ericrobles320140/Chilly-Dog-Team-31-ECEN_404/403/403/Con Ops/Block Diagram.docx

power cord power cord cool/warm air

Car Window

Solar Panels

hose air intake

12 V Outlet

power cord power

HVAC system

Battery

power

Microcontroller

temperature control

temperature sensor

wifi temperature settings

Phone Application
