ericrobles320140/Chilly-Dog-Team-31-ECEN_404/403/403/Con Ops/Figures 3.1 and 3.2.pptx

Clip

Exhaust Hose

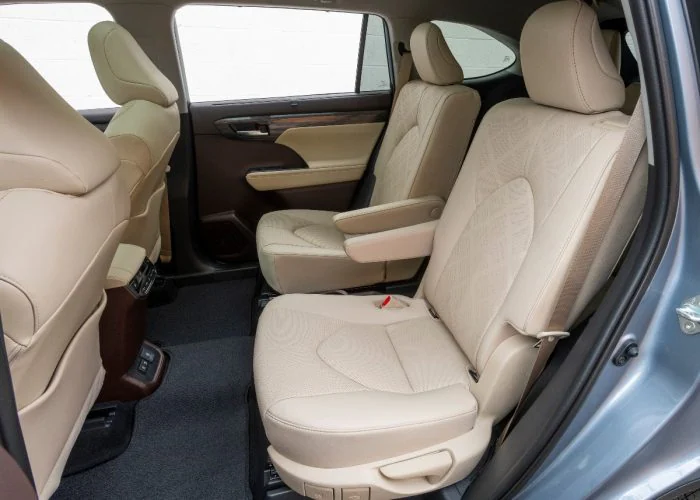
[picture p31: figure]

Power Button

Air Output

## Slide 2

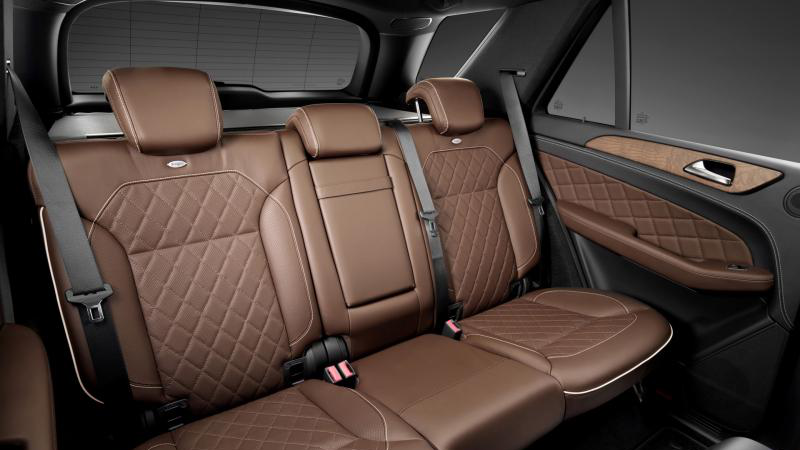
[picture p32: figure]

Exhaust Hose

Air Output

Car Plug

## Slide 3

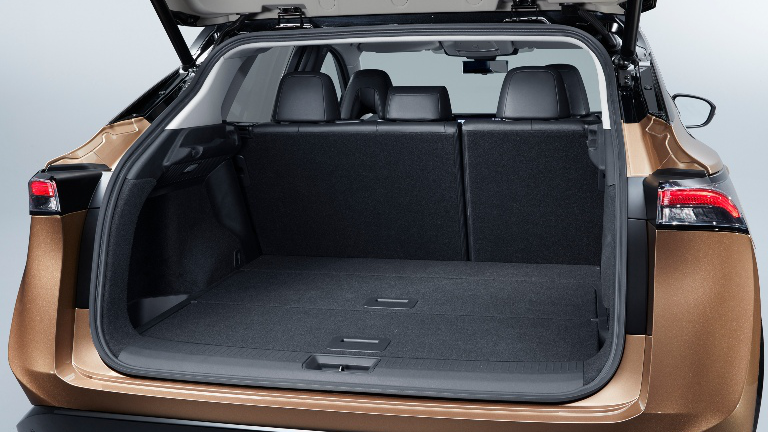
[picture p33: figure]

Air Output

Car Plug

## Slide 4

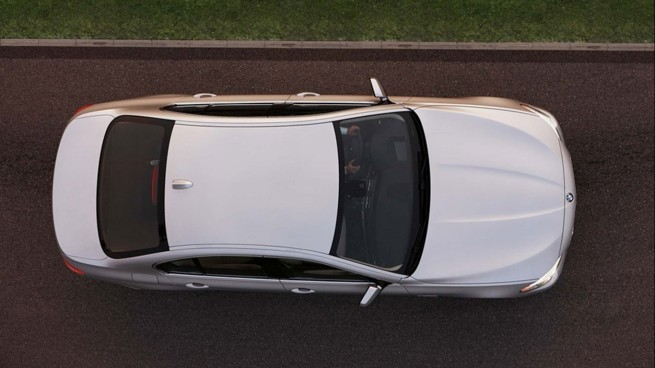
[picture p34: figure]
Results Now In: Guess These 10 Cars From A Bird&#39;s Eye View: Part 2

Solar Panels
