ericrobles320140/Chilly-Dog-Team-31-ECEN_404/Power/Power Supply/Power Supply Simulation/Power Supply Circuit Simulations.docx

MCU WEBENCH

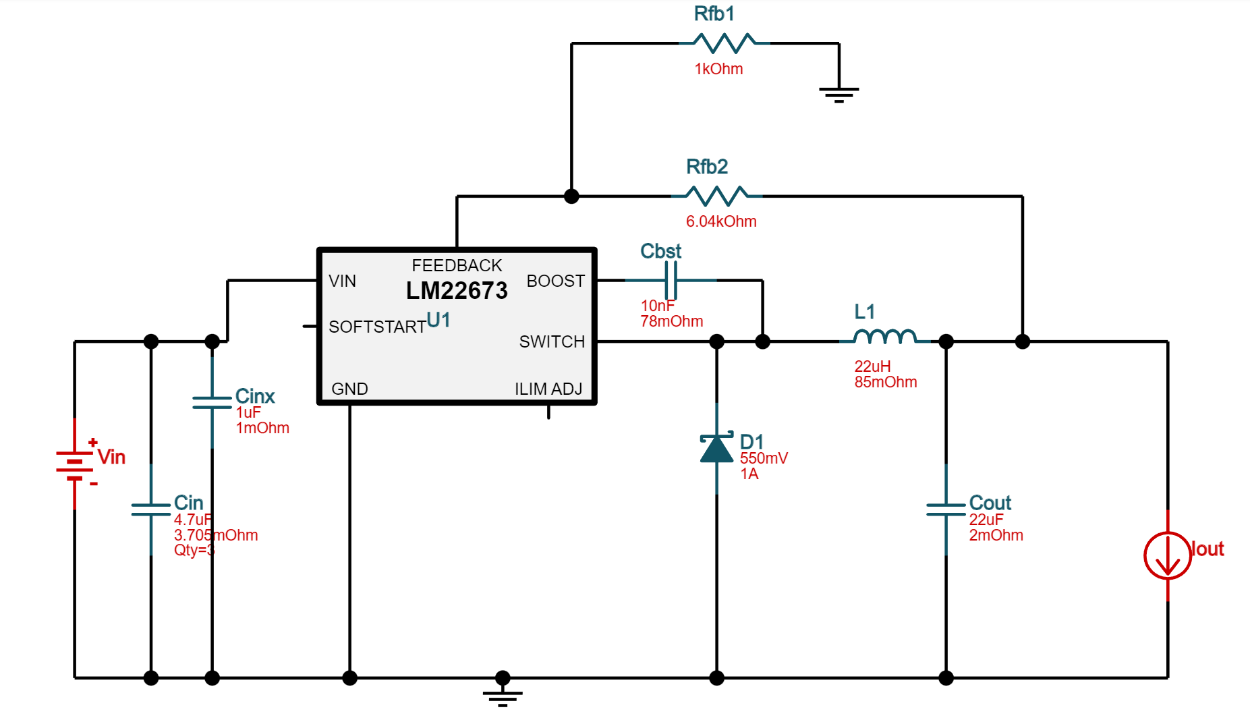
[picture p146: figure]

- Load Regulation

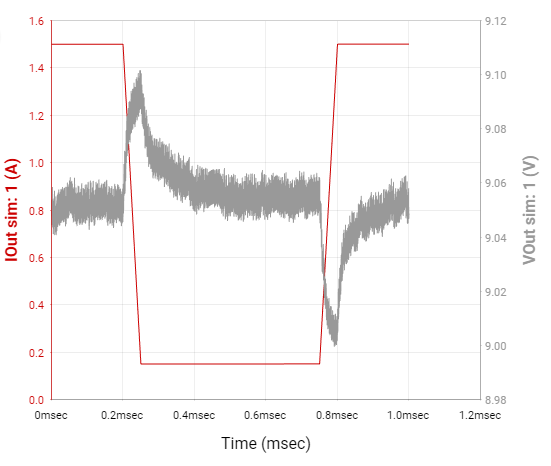
[picture p147: figure]

- Line Regulation

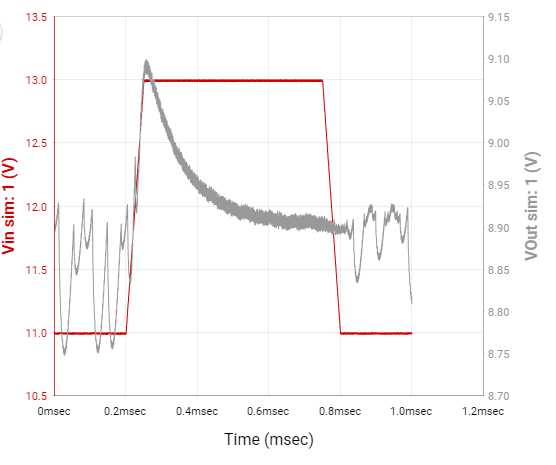
[picture p148: figure]

MODEM WEBENCH

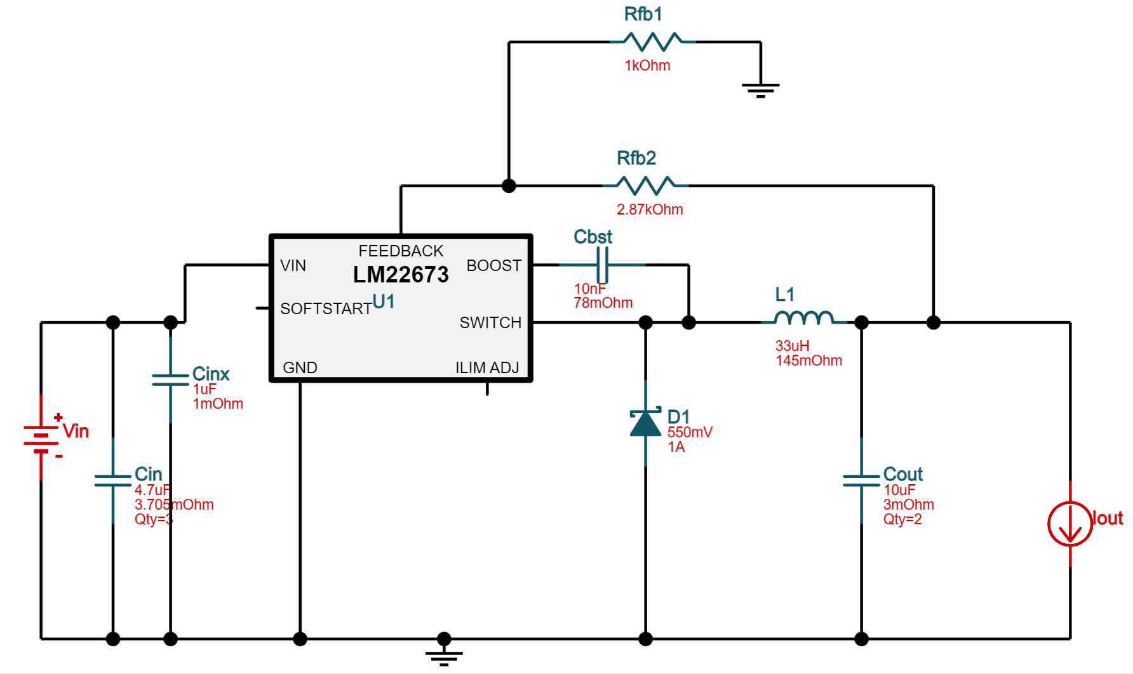
[picture p149: figure]

- Load Regulation

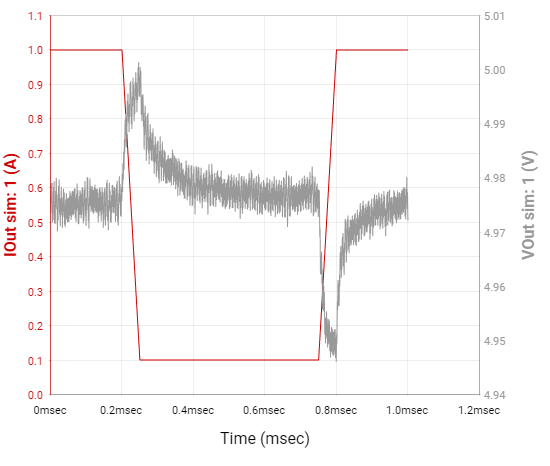
[picture p150: figure]

- Line Regulation

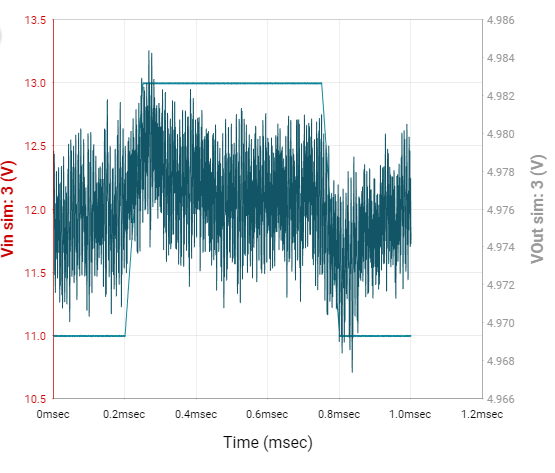
[picture p151: figure]
