ericrobles320140/Chilly-Dog-Team-31-ECEN_404/403/403/General Resources/Capstone Block Diagram.png

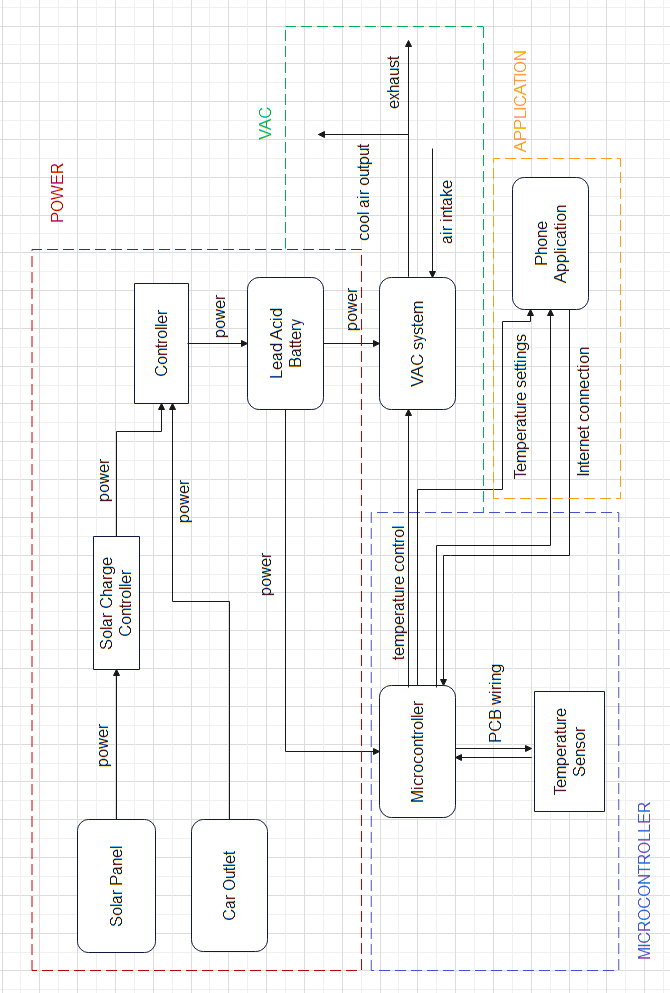
403/403/General Resources/Capstone Block Diagram.png
