ericrobles320140/Chilly-Dog-Team-31-ECEN_404/App and Modem/adding-different-dev.png

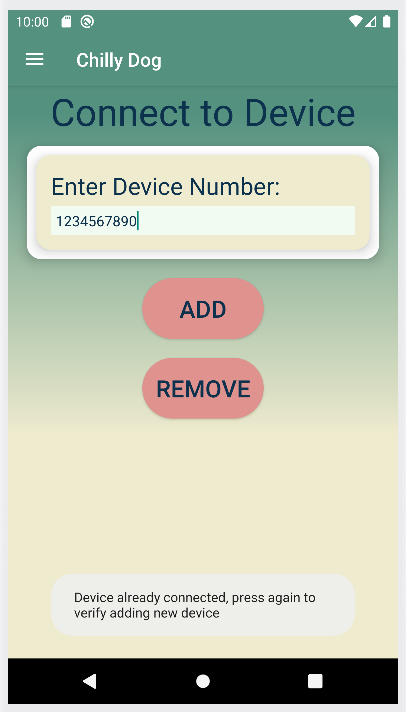
App and Modem/adding-different-dev.png
