ericrobles320140/Chilly-Dog-Team-31-ECEN_404/App and Modem/App-Home.png

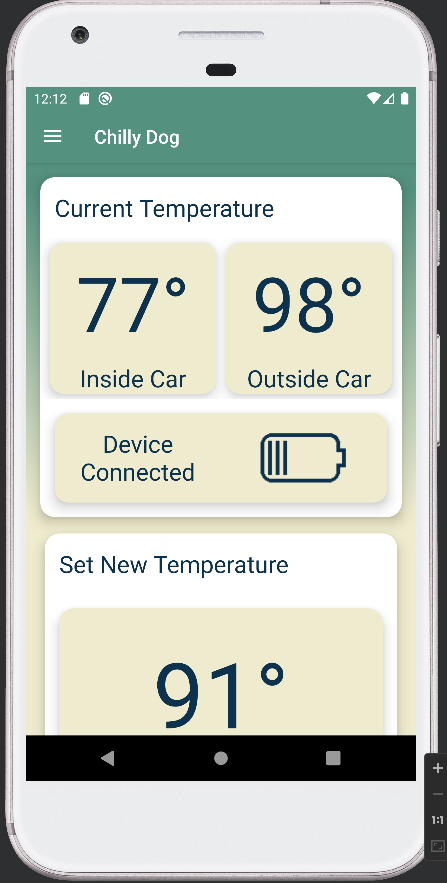
App and Modem/App-Home.png
