ericrobles320140/Chilly-Dog-Team-31-ECEN_404/App and Modem/app_warning_codes.png

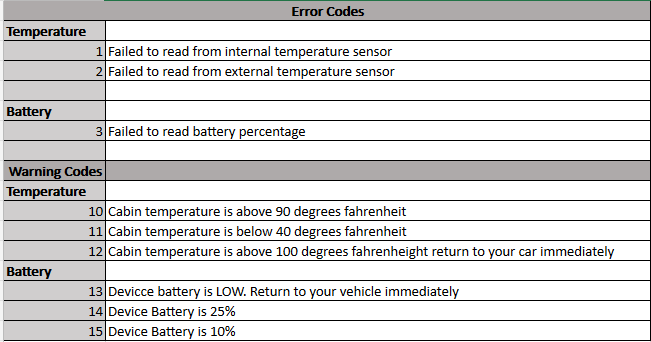
App and Modem/app_warning_codes.png
