ericrobles320140/Chilly-Dog-Team-31-ECEN_404/App and Modem/AppConDev.png

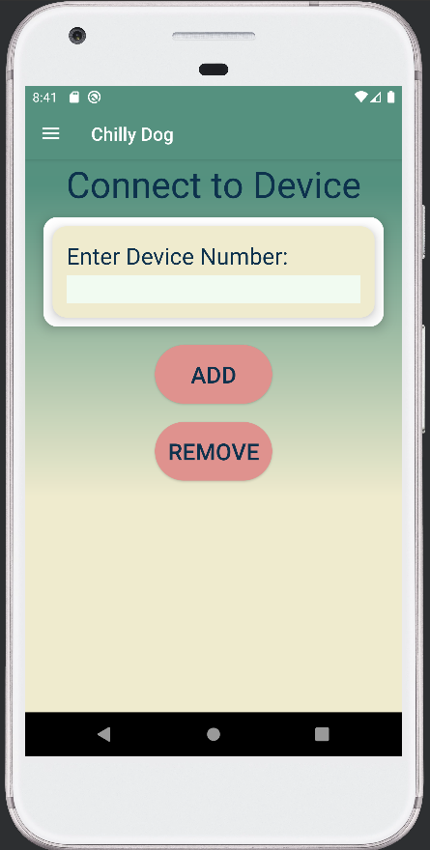
App and Modem/AppConDev.png
