ericrobles320140/Chilly-Dog-Team-31-ECEN_404/App and Modem/AppHome.png

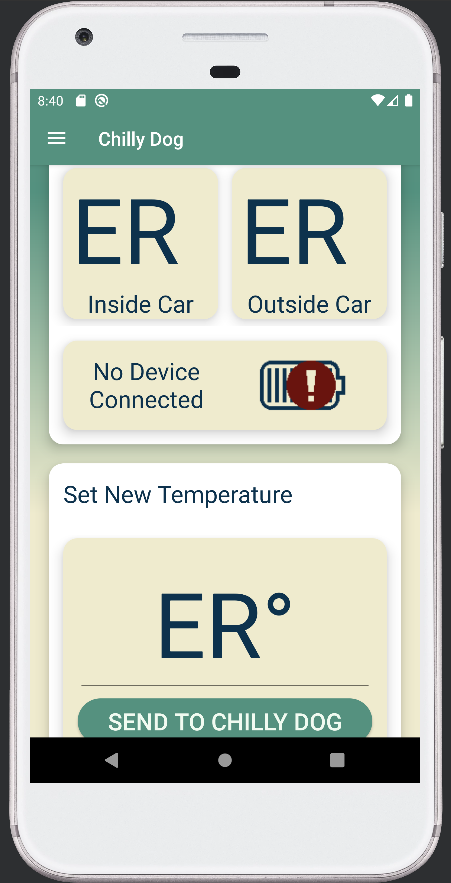
App and Modem/AppHome.png
