ericrobles320140/Chilly-Dog-Team-31-ECEN_404/App and Modem/AppNotif.png

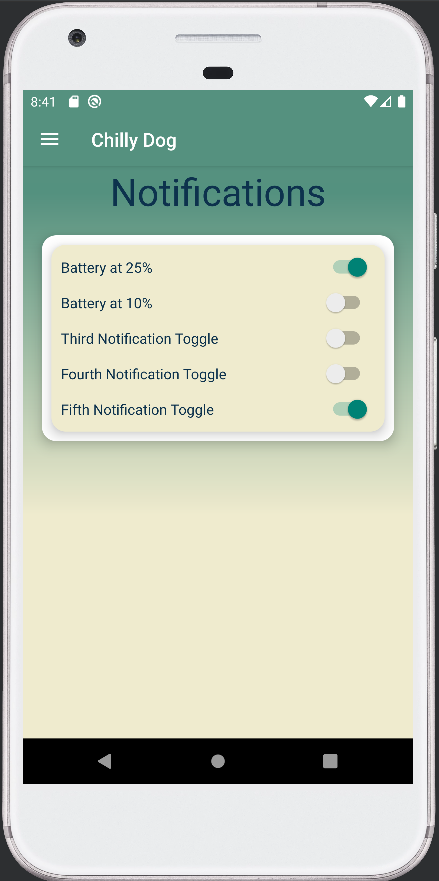
App and Modem/AppNotif.png
