ericrobles320140/Chilly-Dog-Team-31-ECEN_404/App and Modem/AppShowUpdate.png

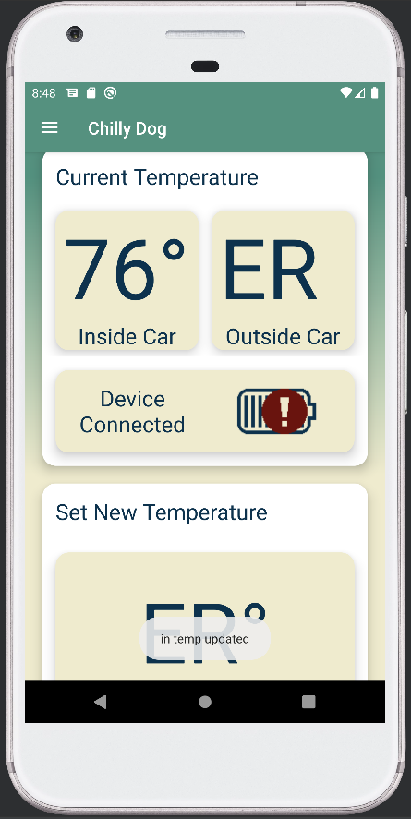
App and Modem/AppShowUpdate.png
