ericrobles320140/Chilly-Dog-Team-31-ECEN_404/App and Modem/bluetooth_permissions.png

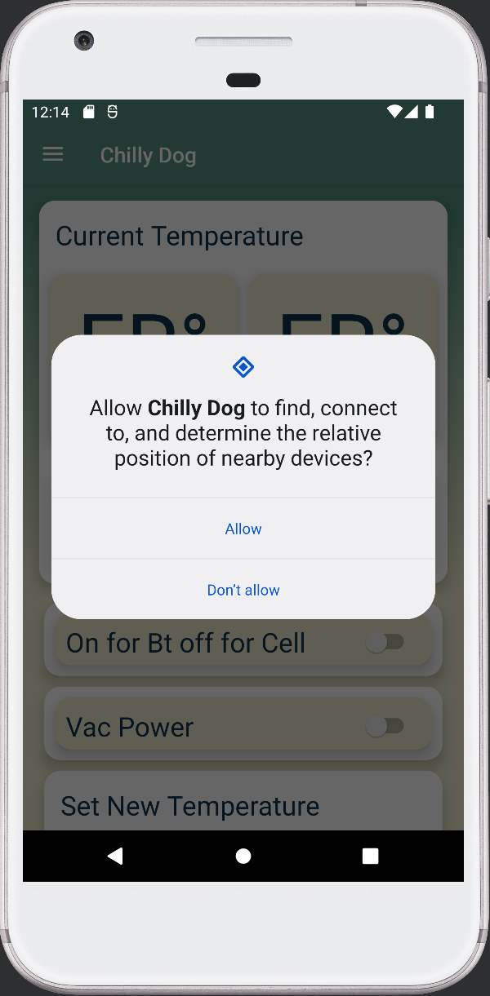
App and Modem/bluetooth_permissions.png
