ericrobles320140/Chilly-Dog-Team-31-ECEN_404/App and Modem/cleared-device.png

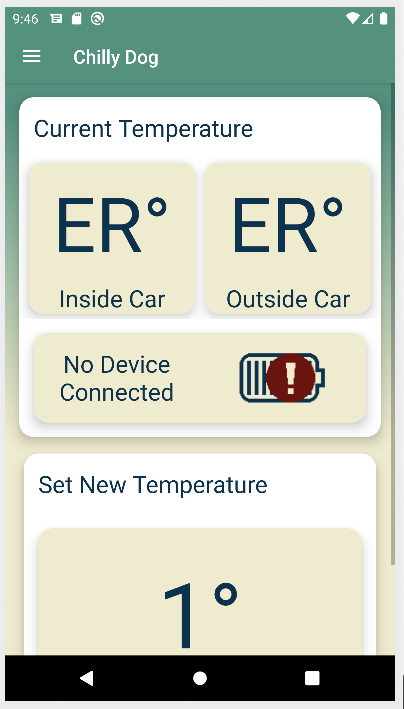
App and Modem/cleared-device.png
