ericrobles320140/Chilly-Dog-Team-31-ECEN_404/App and Modem/connect_device_screen.png

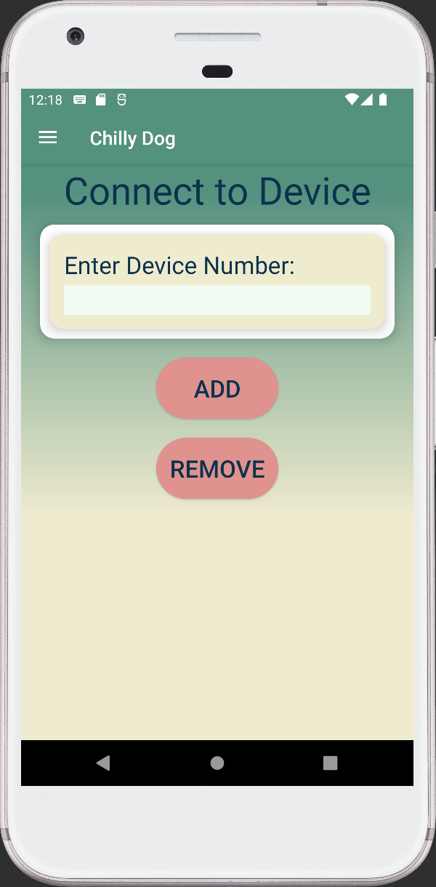
App and Modem/connect_device_screen.png
