ericrobles320140/Chilly-Dog-Team-31-ECEN_404/App and Modem/correct-send.png

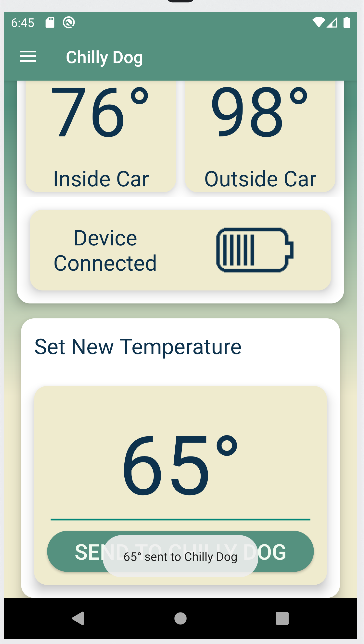
App and Modem/correct-send.png
