ericrobles320140/Chilly-Dog-Team-31-ECEN_404/App and Modem/decimal-adddev.png

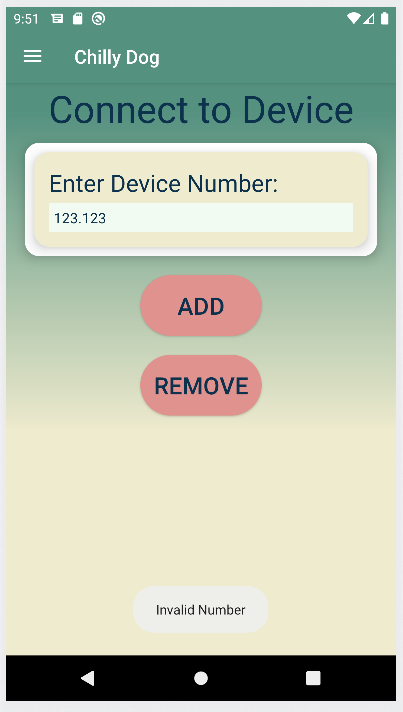
App and Modem/decimal-adddev.png
