ericrobles320140/Chilly-Dog-Team-31-ECEN_404/App and Modem/err1.png

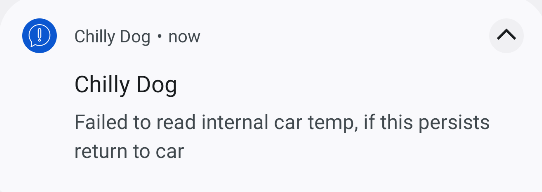
App and Modem/err1.png
