ericrobles320140/Chilly-Dog-Team-31-ECEN_404/App and Modem/err13.png

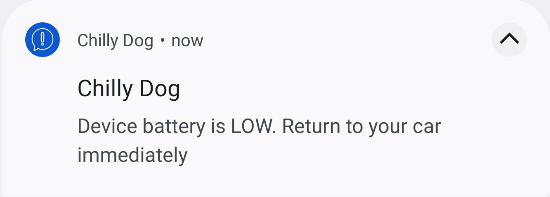
App and Modem/err13.png
