ericrobles320140/Chilly-Dog-Team-31-ECEN_404/App and Modem/homescreen_filled.png

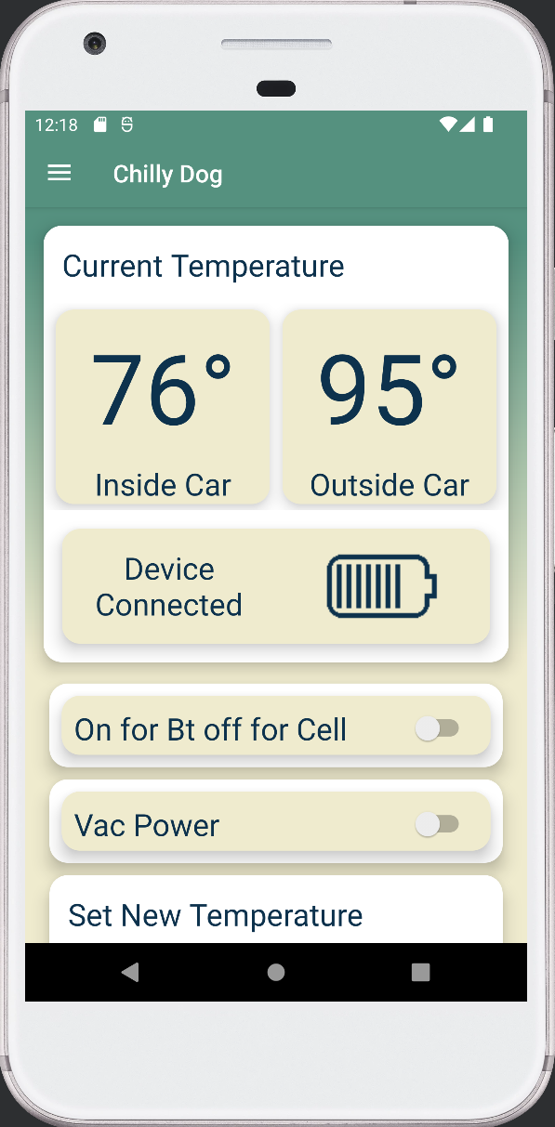
App and Modem/homescreen_filled.png
