ericrobles320140/Chilly-Dog-Team-31-ECEN_404/App and Modem/homescreen_no_fill.png

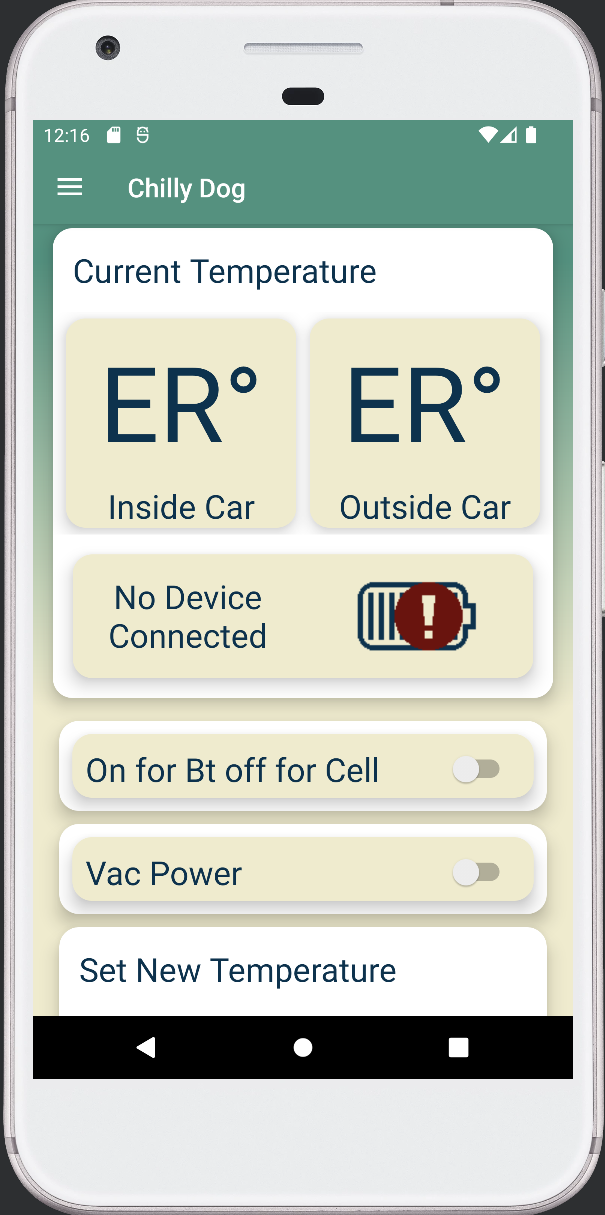
App and Modem/homescreen_no_fill.png
