ericrobles320140/Chilly-Dog-Team-31-ECEN_404/App and Modem/incorrect-nodigit2-adddev.png

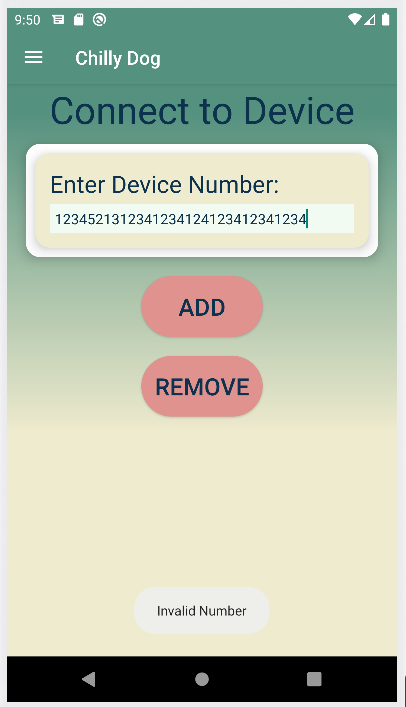
App and Modem/incorrect-nodigit2-adddev.png
