ericrobles320140/Chilly-Dog-Team-31-ECEN_404/App and Modem/modem_out_3.png

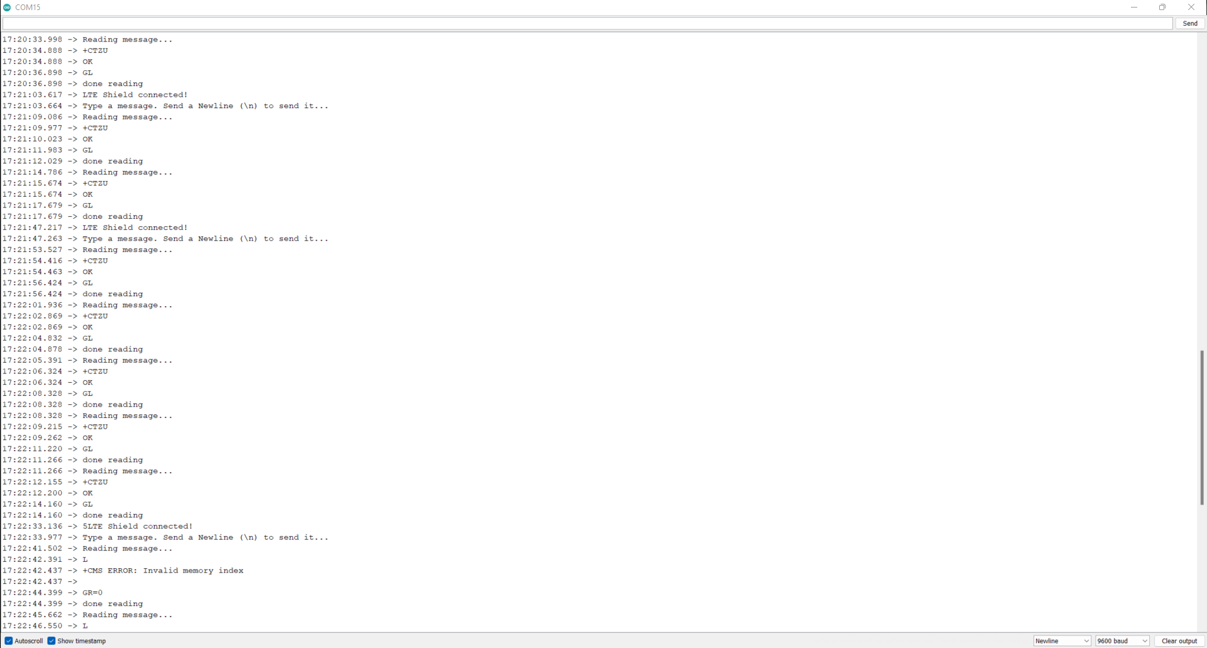
App and Modem/modem_out_3.png
