ericrobles320140/Chilly-Dog-Team-31-ECEN_404/App and Modem/nan check.png

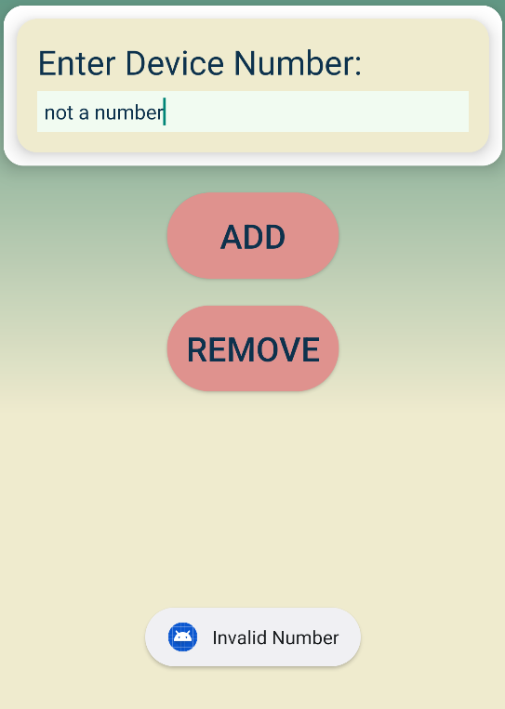
App and Modem/nan check.png
