ericrobles320140/Chilly-Dog-Team-31-ECEN_404/App and Modem/notif-on-and-rec.png

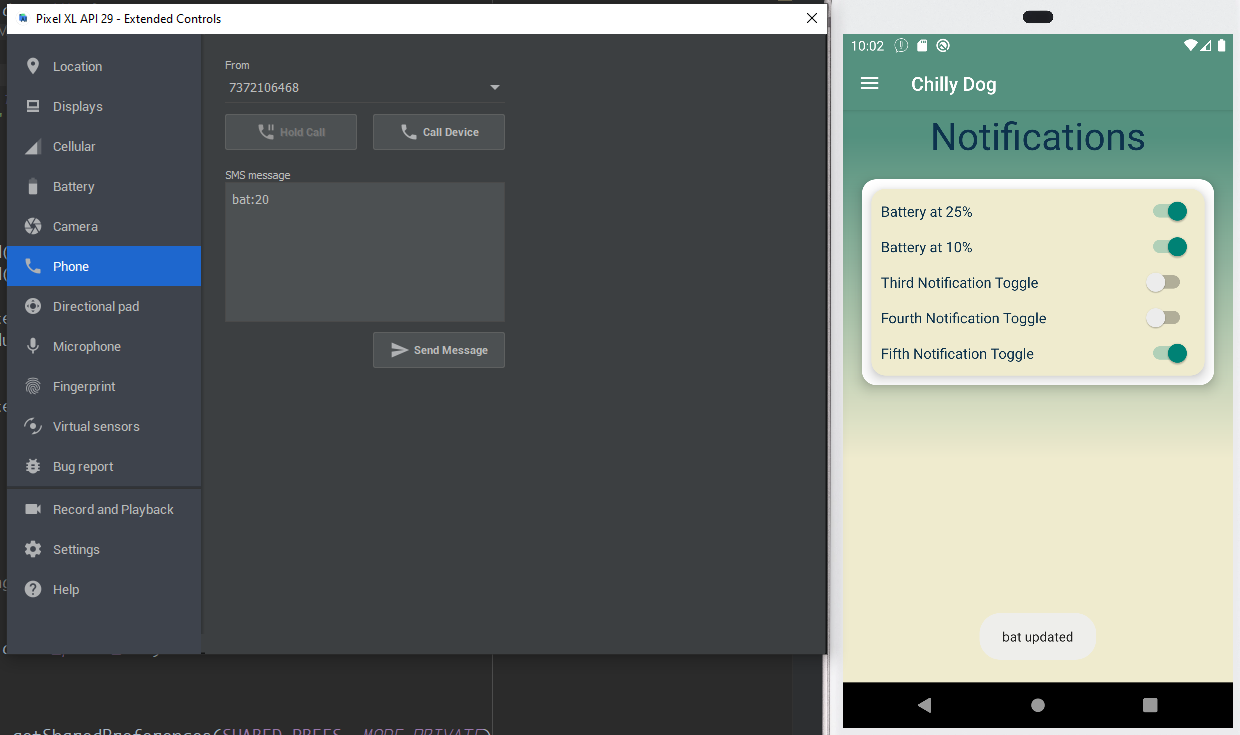
App and Modem/notif-on-and-rec.png
