ericrobles320140/Chilly-Dog-Team-31-ECEN_404/App and Modem/notification-off.png

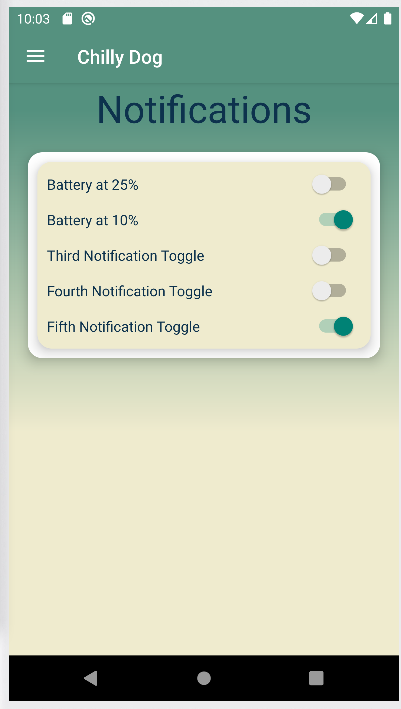
App and Modem/notification-off.png
