ericrobles320140/Chilly-Dog-Team-31-ECEN_404/App and Modem/notification-on.png

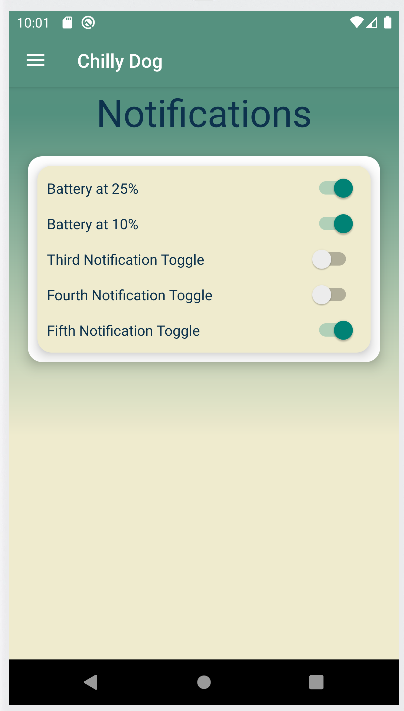
App and Modem/notification-on.png
