ericrobles320140/Chilly-Dog-Team-31-ECEN_404/App and Modem/out-of-range-sent-again.png

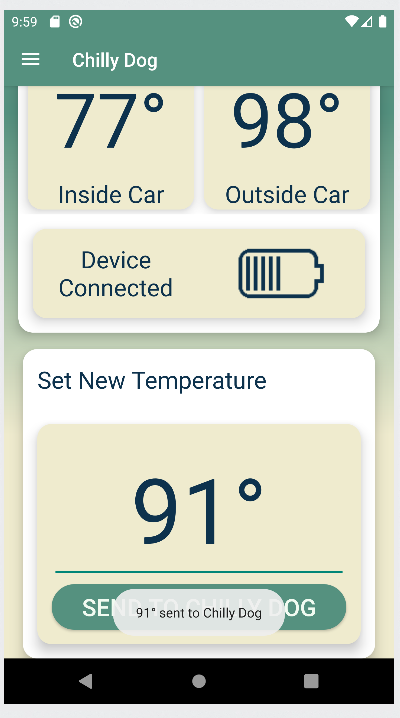
App and Modem/out-of-range-sent-again.png
