ericrobles320140/Chilly-Dog-Team-31-ECEN_404/App and Modem/send-temp-nodev.png

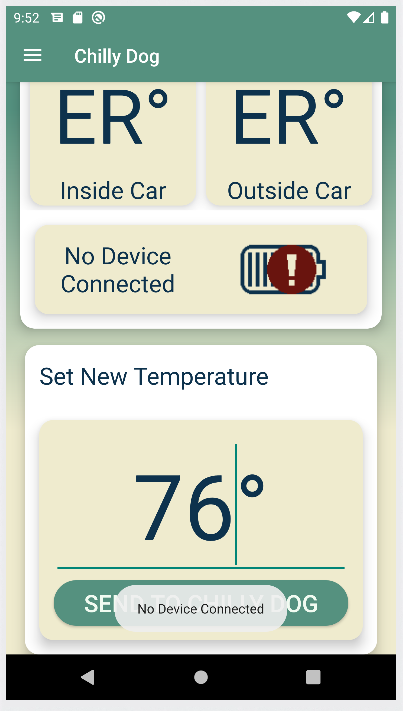
App and Modem/send-temp-nodev.png
