ericrobles320140/Chilly-Dog-Team-31-ECEN_404/App and Modem/side_menu.png

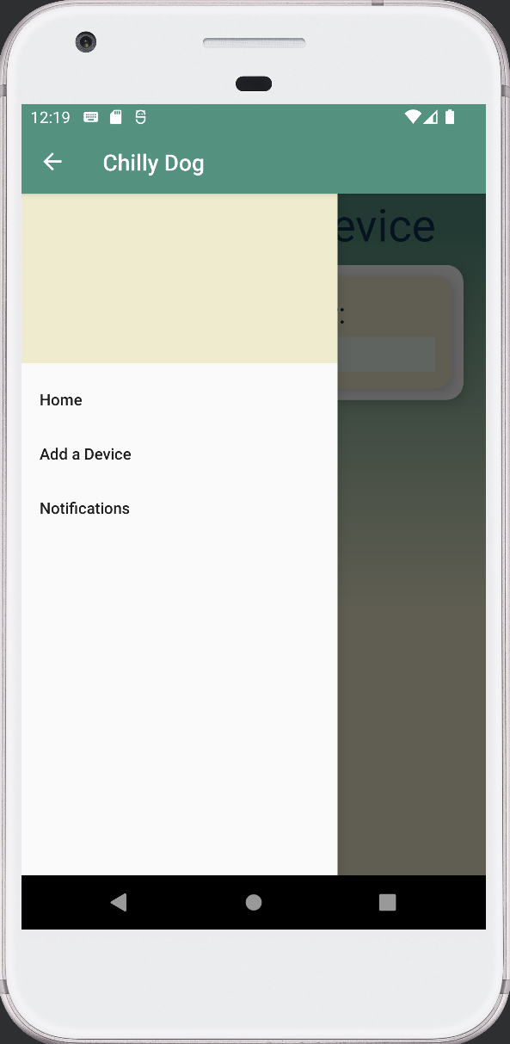
App and Modem/side_menu.png
