ericrobles320140/Chilly-Dog-Team-31-ECEN_404/App and Modem/SMS_permissions.png

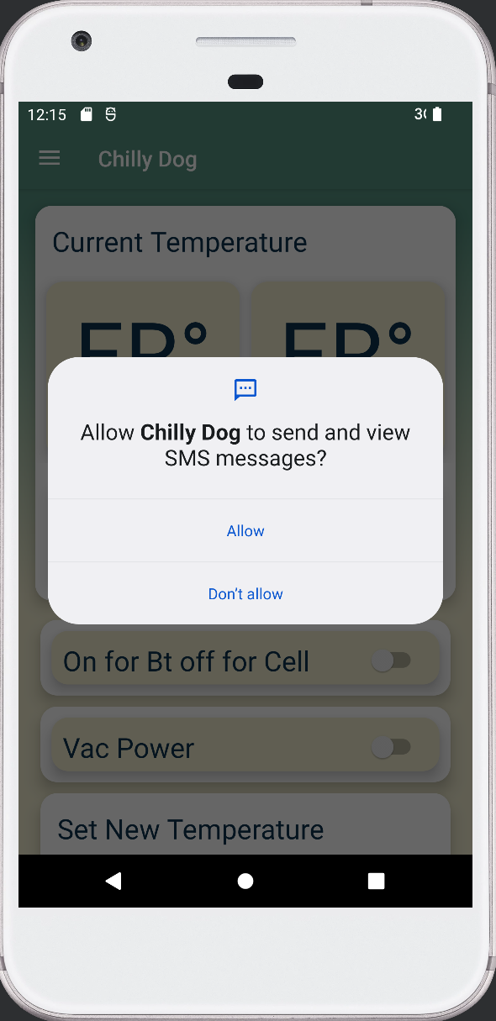
App and Modem/SMS_permissions.png
