ericrobles320140/Chilly-Dog-Team-31-ECEN_404/App and Modem/temp-out-of-range.png

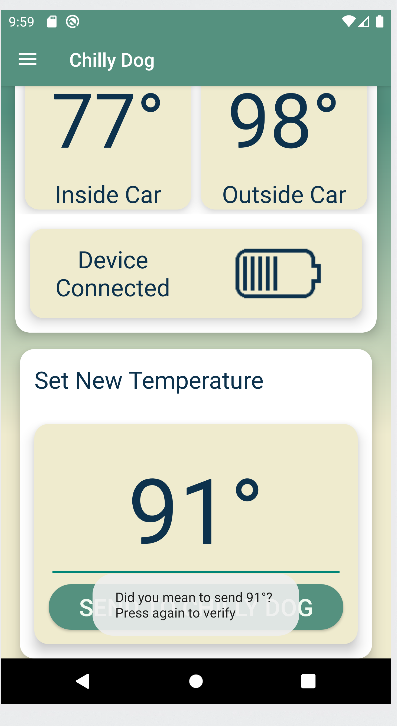
App and Modem/temp-out-of-range.png
