ericrobles320140/Chilly-Dog-Team-31-ECEN_404/App and Modem/Textreceive.png

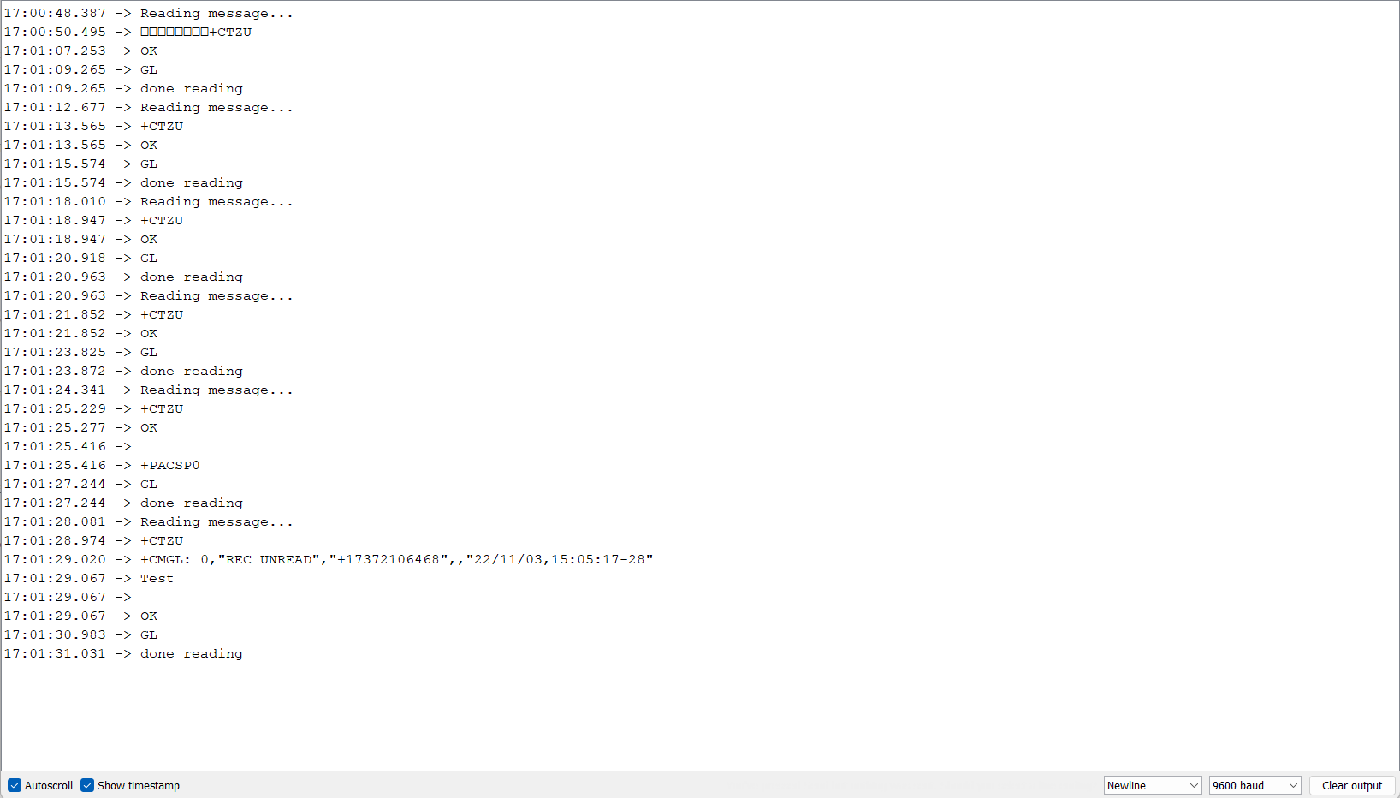
App and Modem/Textreceive.png
