ericrobles320140/Chilly-Dog-Team-31-ECEN_404/App and Modem/update-battery.png

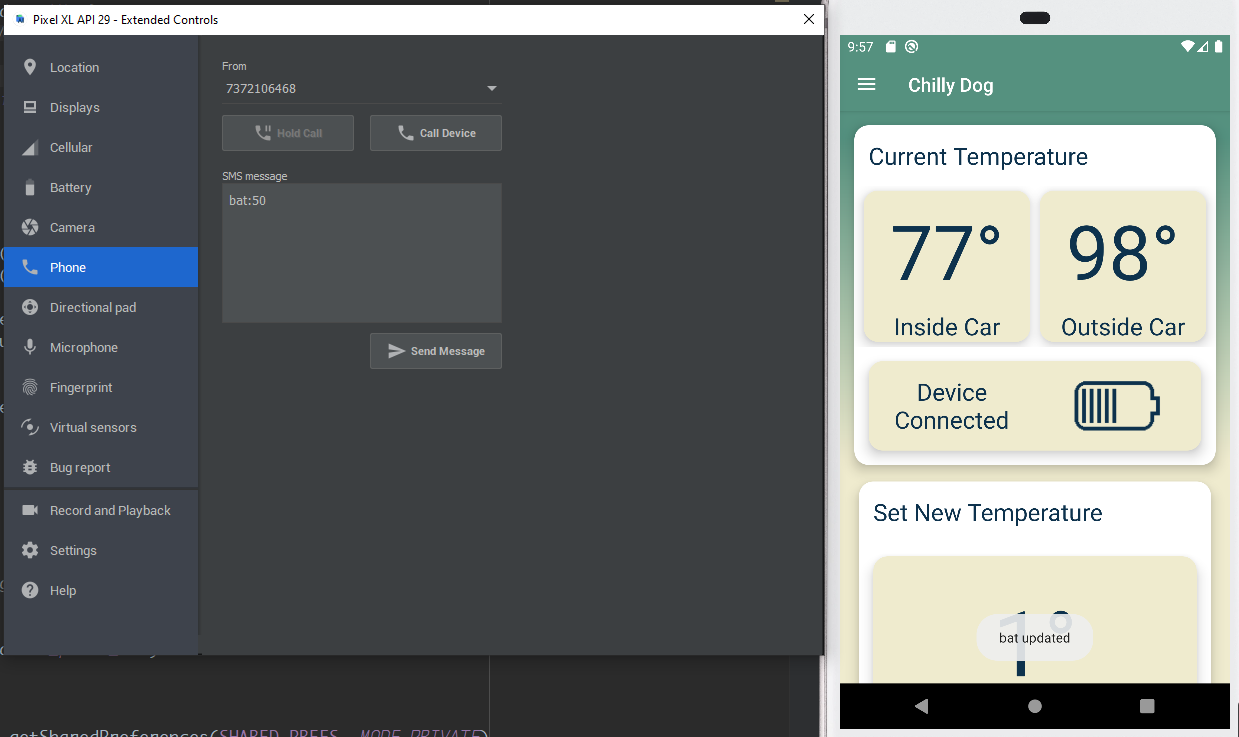
App and Modem/update-battery.png
