ericrobles320140/Chilly-Dog-Team-31-ECEN_404/App and Modem/word-in-send.png

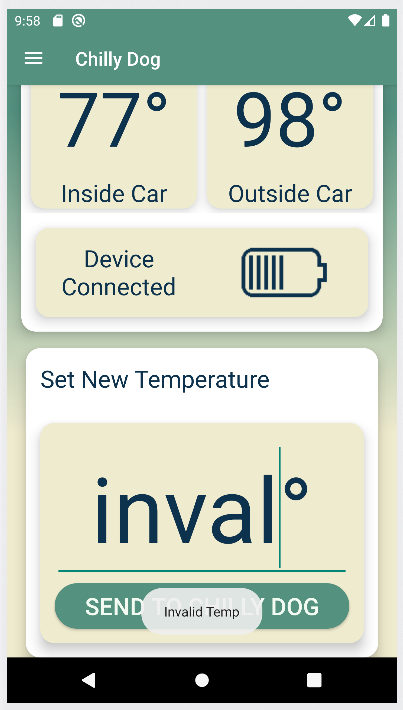
App and Modem/word-in-send.png
