ericrobles320140/Chilly-Dog-Team-31-ECEN_404/App and Modem/word-space-inadddev.png

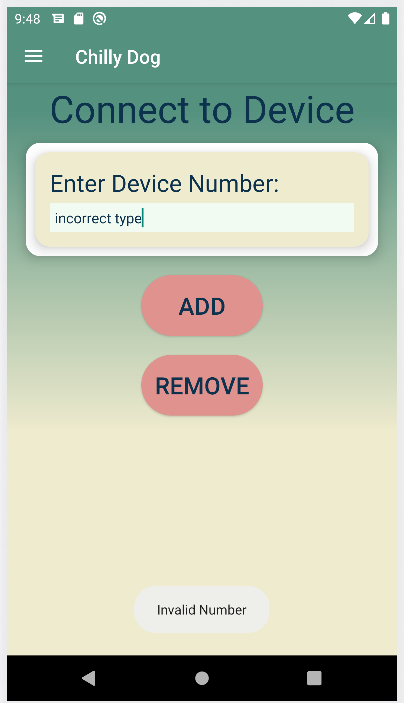
App and Modem/word-space-inadddev.png
