ericrobles320140/Chilly-Dog-Team-31-ECEN_404/MCU/ECEN 404/Arduino Code/DHT_Sensor/Both Sensor Screenshots/Both Temp SC.PNG

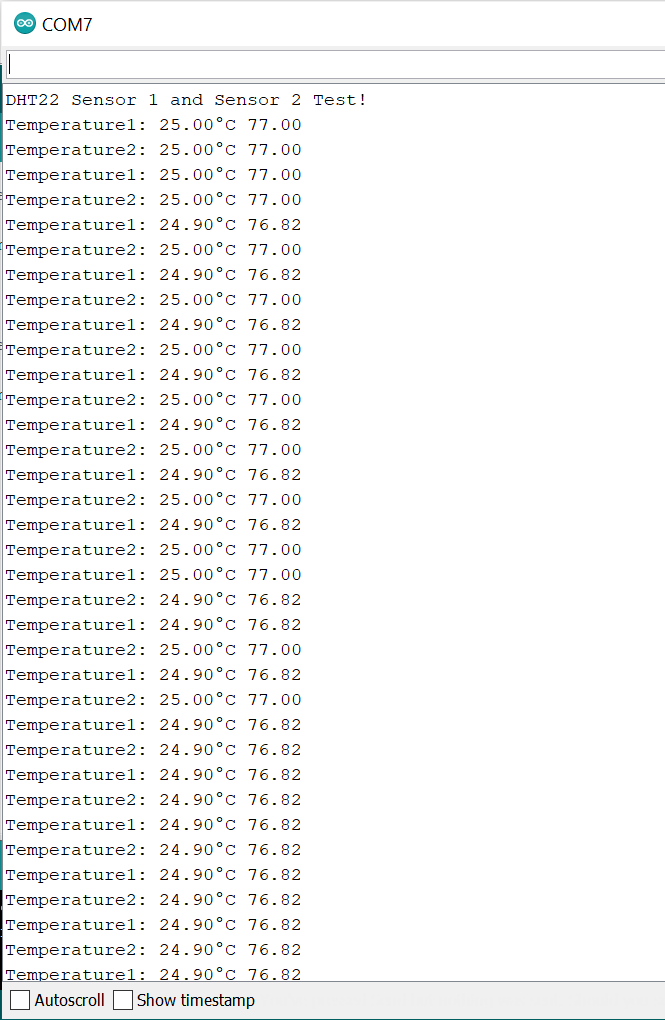
MCU/ECEN 404/Arduino Code/DHT_Sensor/Both Sensor Screenshots/Both Temp SC.PNG
