ericrobles320140/Chilly-Dog-Team-31-ECEN_404/MCU/ECEN 404/Arduino Code/DHT_Sensor/Sensor 1 Screenshots/SC 1.PNG

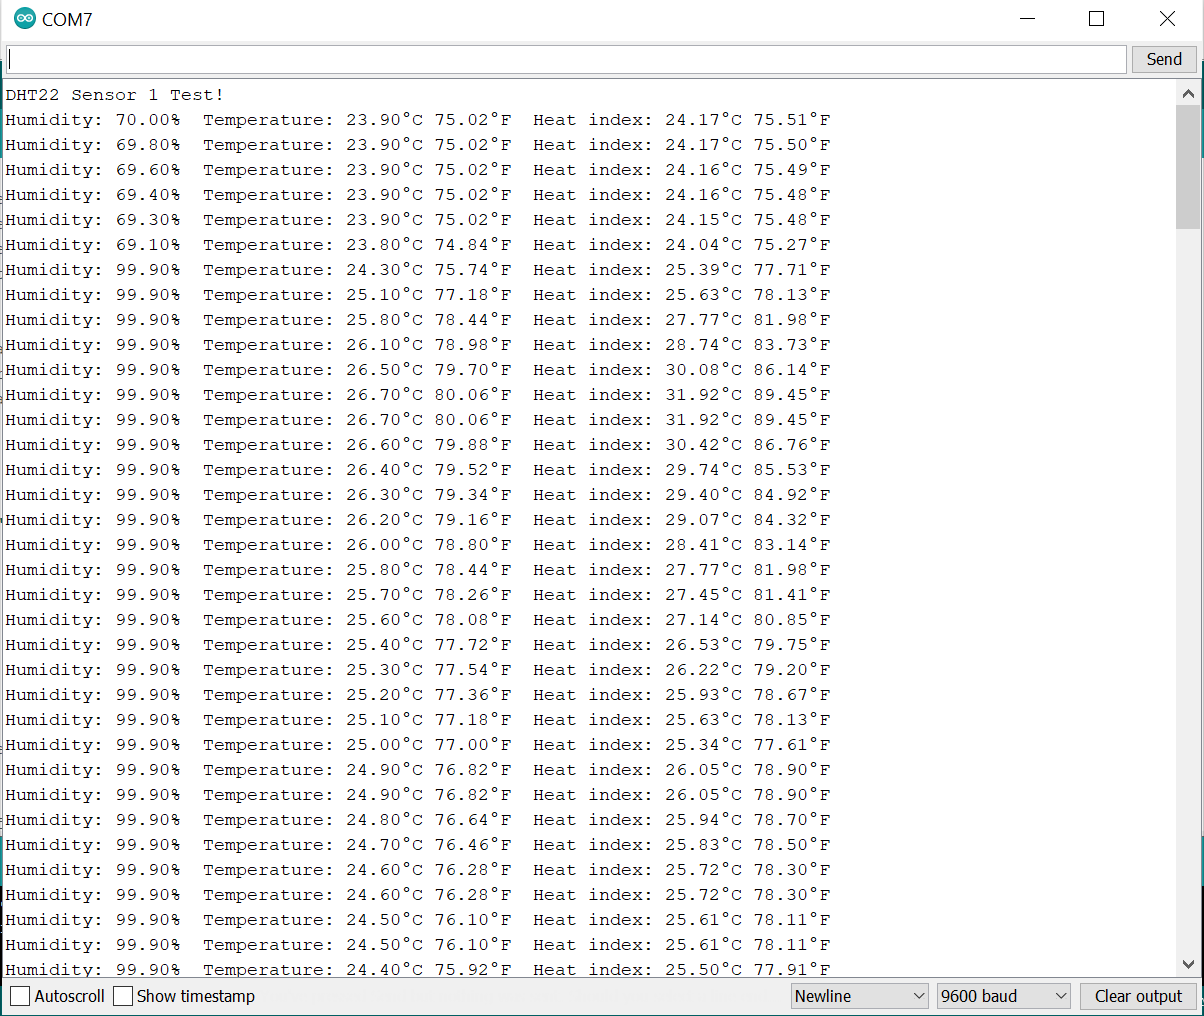
MCU/ECEN 404/Arduino Code/DHT_Sensor/Sensor 1 Screenshots/SC 1.PNG
