ericrobles320140/Chilly-Dog-Team-31-ECEN_404/App and Modem/Enclosure/Encloser Ass.SLDASM

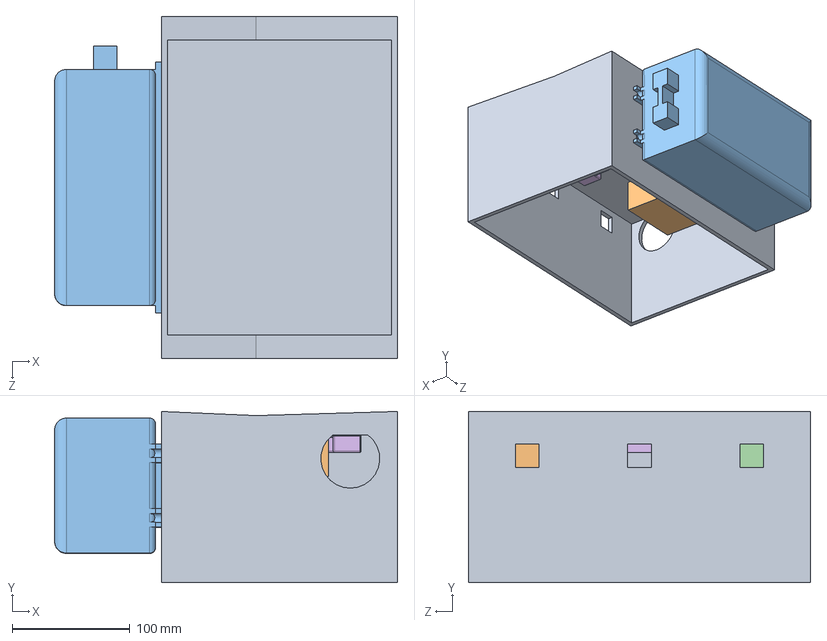
[picture p201: CAD file, 2022-12-01]
App and Modem/Enclosure/Encloser Ass.SLDASM
290.7 x 145.0 x 290.0 mm
Encloser Bottom
Charge Controller
Inverter
PCB Stack
Motor Power
Wire Splitter
