ericrobles320140/Chilly-Dog-Team-31-ECEN_404/MCU/ECEN 404/SOLIDWORKS/Box and motor.SLDASM

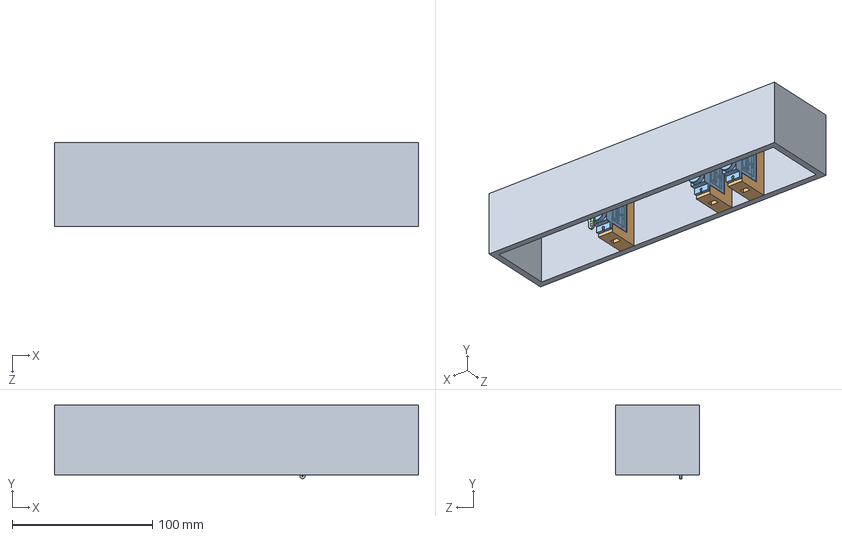
[picture p202: CAD file, 2022-12-01]
MCU/ECEN 404/SOLIDWORKS/Box and motor.SLDASM
260.0 x 52.5 x 60.0 mm
holder x 3
SG90 x 3
SG90_ARM
