ericrobles320140/Chilly-Dog-Team-31-ECEN_404/App and Modem/Enclosure/Encloser Bottom.SLDPRT

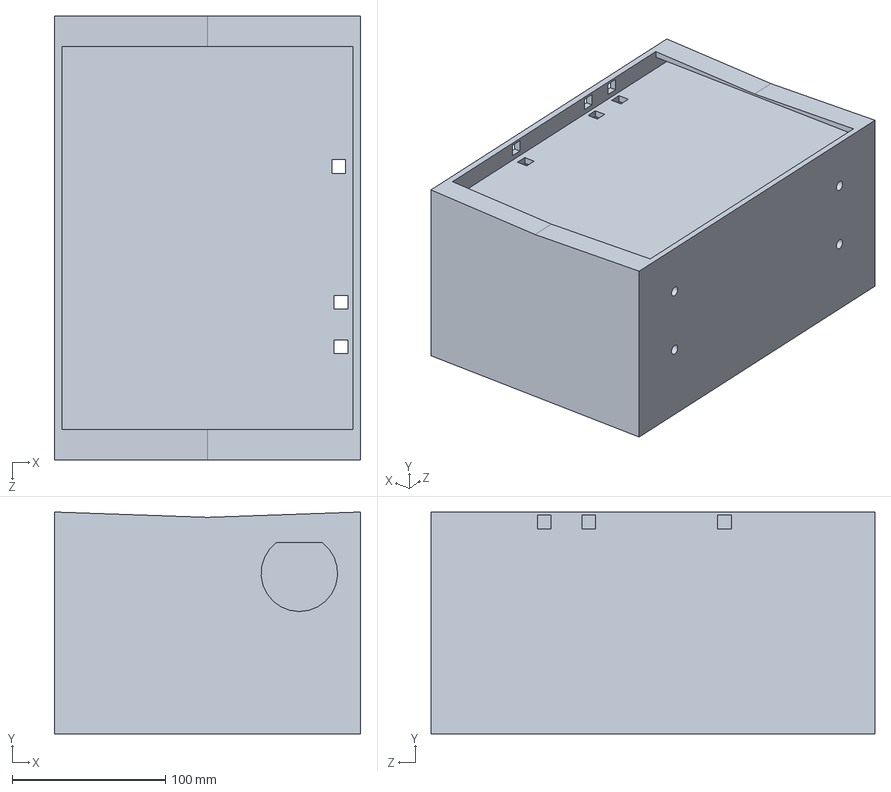
[picture p203: CAD file, 2022-12-01]
App and Modem/Enclosure/Encloser Bottom.SLDPRT
200.0 x 145.0 x 290.0 mm
