ericrobles320140/Chilly-Dog-Team-31-ECEN_404/MCU/ECEN 404/SOLIDWORKS/holder.SLDPRT

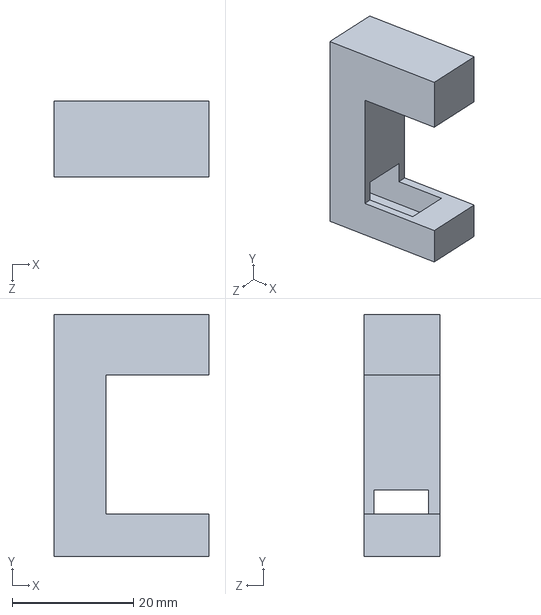
[picture p204: CAD file, 2022-12-01]
MCU/ECEN 404/SOLIDWORKS/holder.SLDPRT
25.6 x 40.0 x 12.5 mm
