ericrobles320140/Chilly-Dog-Team-31-ECEN_404/App and Modem/Enclosure/Box and motor - 101522-1.SLDPRT

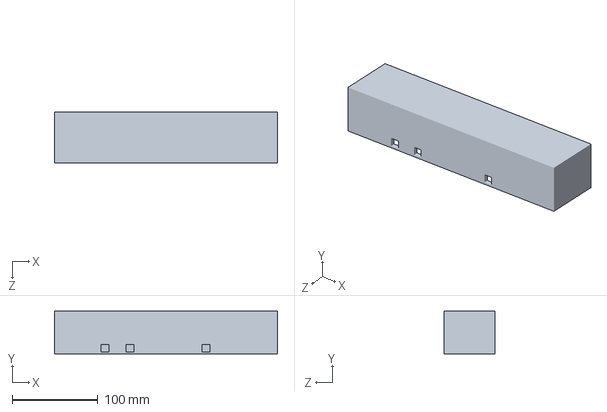
[picture p205: CAD file, 2022-12-01]
App and Modem/Enclosure/Box and motor - 101522-1.SLDPRT
260.0 x 50.0 x 60.0 mm
