ericrobles320140/Chilly-Dog-Team-31-ECEN_404/MCU/ECEN 404/SOLIDWORKS/Temperature cover.SLDPRT

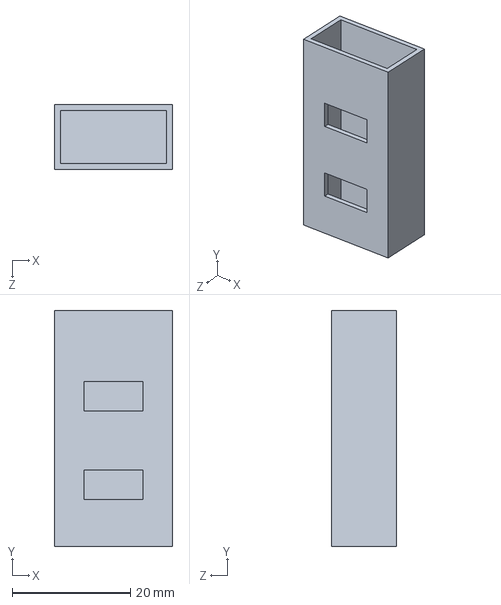
[picture p206: CAD file, 2022-12-01]
MCU/ECEN 404/SOLIDWORKS/Temperature cover.SLDPRT
20.0 x 40.0 x 11.0 mm
