ericrobles320140/Chilly-Dog-Team-31-ECEN_404/App and Modem/Enclosure/Hose.SLDPRT

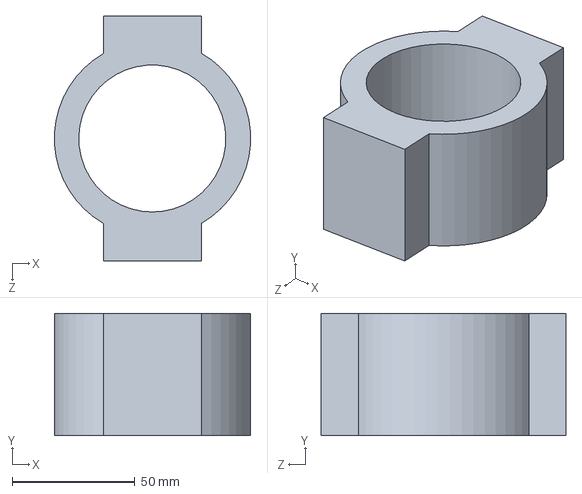
[picture p207: CAD file, 2022-12-01]
App and Modem/Enclosure/Hose.SLDPRT
80.0 x 50.0 x 100.0 mm
