ericrobles320140/Chilly-Dog-Team-31-ECEN_404/MCU/ECEN 404/SOLIDWORKS/Command Strip Base.SLDPRT

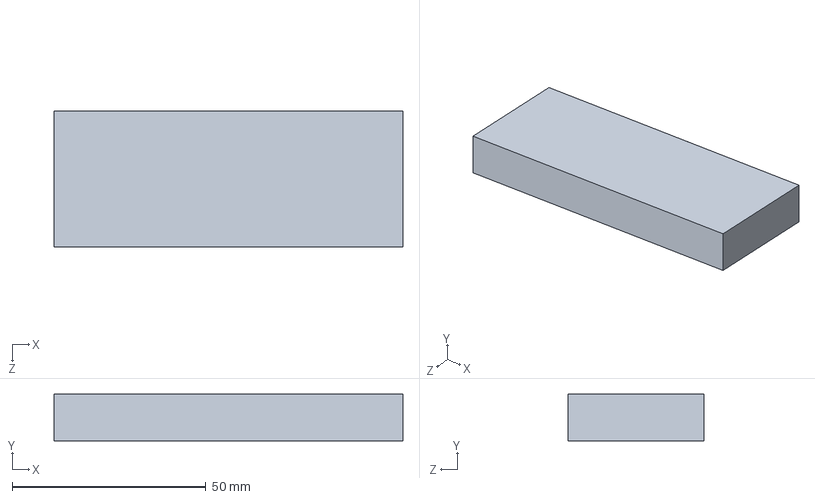
[picture p208: CAD file, 2022-12-01]
MCU/ECEN 404/SOLIDWORKS/Command Strip Base.SLDPRT
90.0 x 12.0 x 35.0 mm
