ericrobles320140/Chilly-Dog-Team-31-ECEN_404/App and Modem/Enclosure/Motor Power.SLDPRT

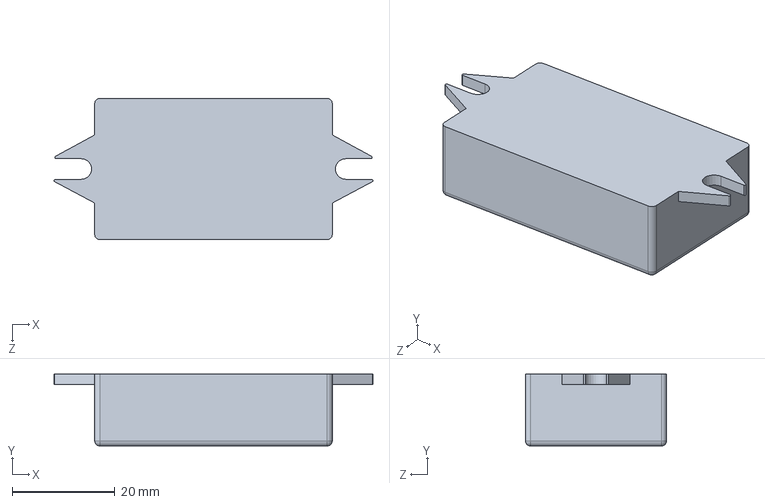
[picture p209: CAD file, 2022-12-01]
App and Modem/Enclosure/Motor Power.SLDPRT
62.1 x 14.0 x 27.5 mm
