ericrobles320140/Chilly-Dog-Team-31-ECEN_404/MCU/ECEN 404/SOLIDWORKS/Final Motor Enclosure.SLDPRT

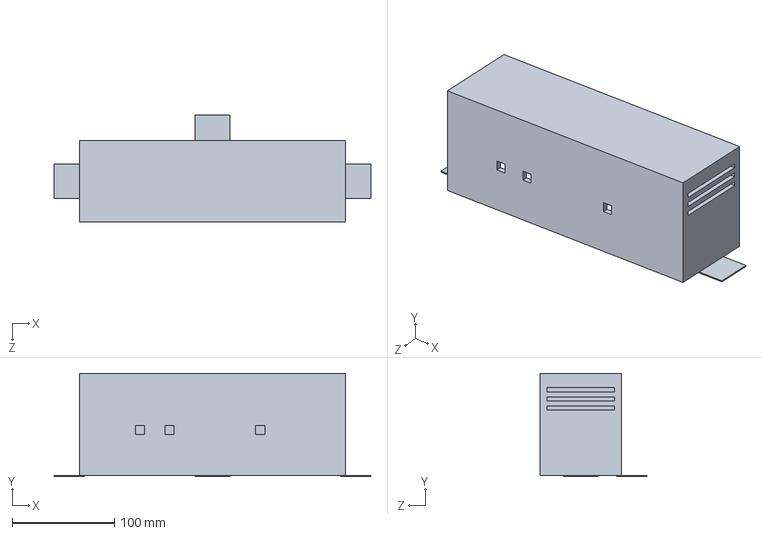
[picture p210: CAD file, 2022-12-01]
MCU/ECEN 404/SOLIDWORKS/Final Motor Enclosure.SLDPRT
310.0 x 101.0 x 105.0 mm
