ericrobles320140/Chilly-Dog-Team-31-ECEN_404/App and Modem/Enclosure/Charge Controller.SLDPRT

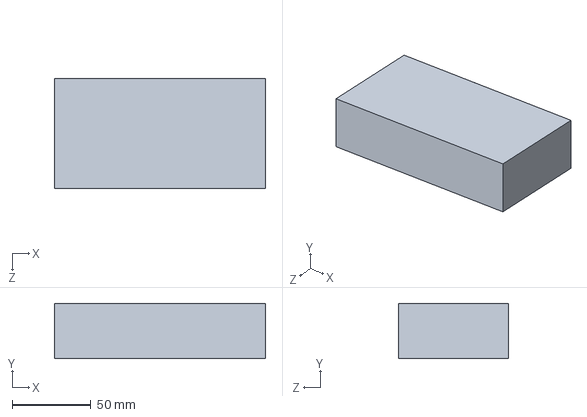
[picture p211: CAD file, 2022-12-01]
App and Modem/Enclosure/Charge Controller.SLDPRT
134.0 x 35.0 x 70.0 mm
