ericrobles320140/Chilly-Dog-Team-31-ECEN_404/MCU/ECEN 404/SOLIDWORKS/Pinion_Gear_Mini_Version1.STL

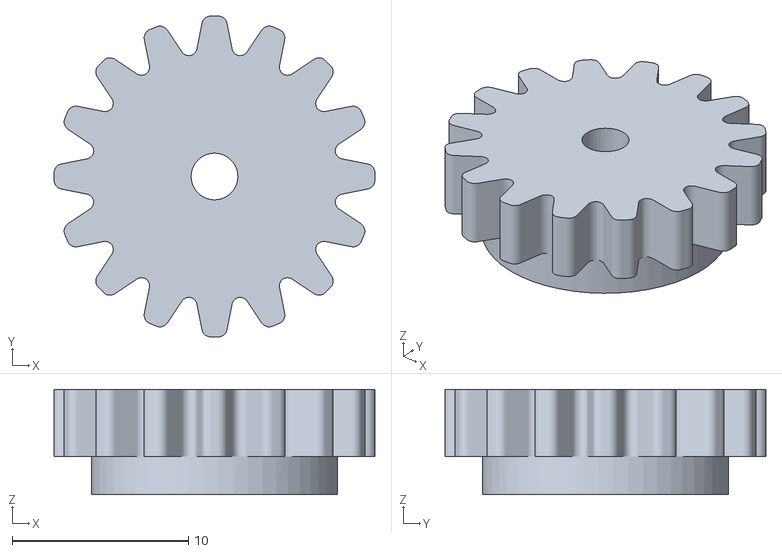
[picture p212: CAD file, 2022-12-01]
MCU/ECEN 404/SOLIDWORKS/Pinion_Gear_Mini_Version1.STL
18.2 x 18.2 x 5.97
