ericrobles320140/Chilly-Dog-Team-31-ECEN_404/App and Modem/Enclosure/PCB Stack.SLDPRT

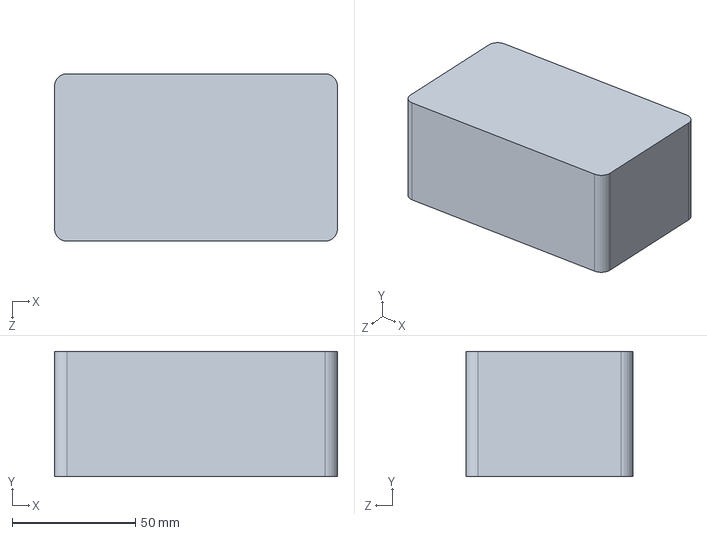
[picture p213: CAD file, 2022-12-01]
App and Modem/Enclosure/PCB Stack.SLDPRT
115.0 x 50.8 x 68.0 mm
