ericrobles320140/Chilly-Dog-Team-31-ECEN_404/MCU/ECEN 404/SOLIDWORKS/Motor_Bracket_Mini_Version1.STL

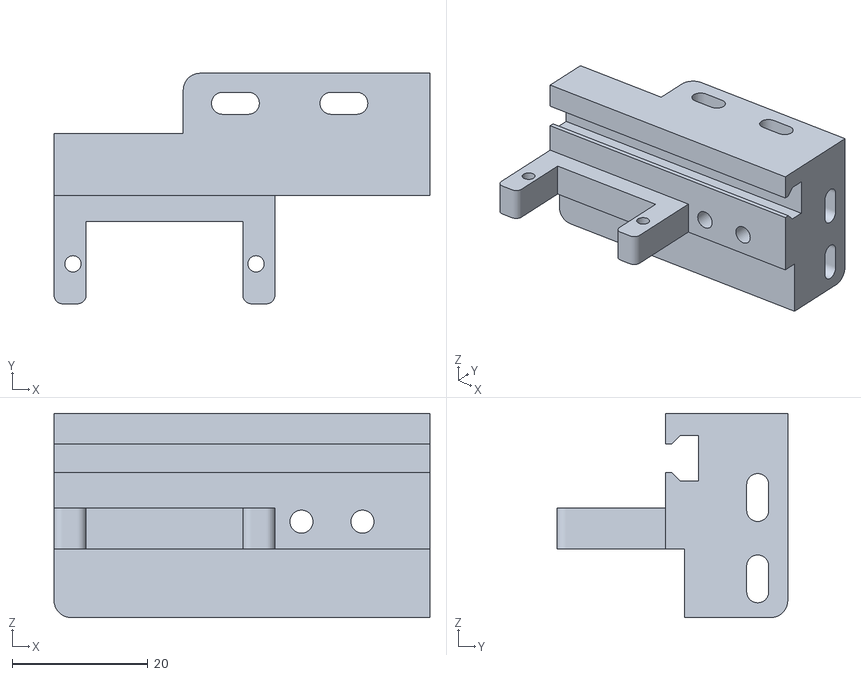
[picture p214: CAD file, 2022-12-01]
MCU/ECEN 404/SOLIDWORKS/Motor_Bracket_Mini_Version1.STL
55.5 x 34.0 x 30.1
