ericrobles320140/Chilly-Dog-Team-31-ECEN_404/App and Modem/Enclosure/Wire Splitter.SLDPRT

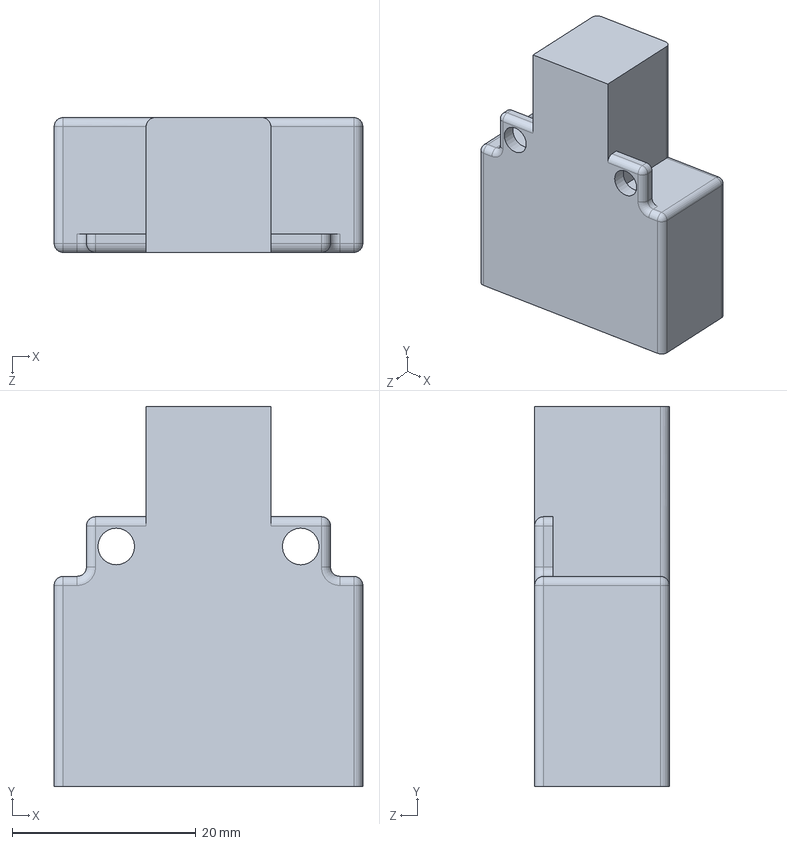
[picture p215: CAD file, 2022-12-01]
App and Modem/Enclosure/Wire Splitter.SLDPRT
33.7 x 41.4 x 14.7 mm
