ericrobles320140/Chilly-Dog-Team-31-ECEN_404/MCU/ECEN 404/SOLIDWORKS/Pusher_75mm_Long1.STL

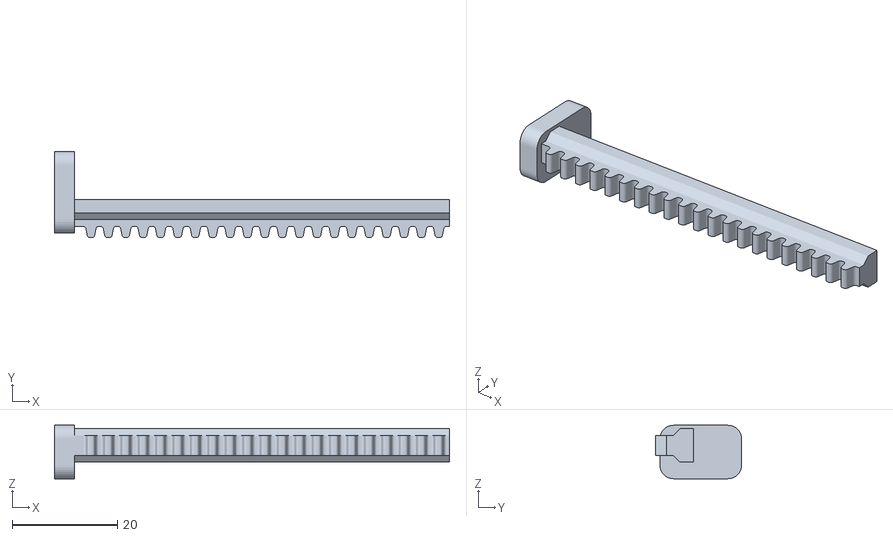
[picture p216: CAD file, 2022-12-01]
MCU/ECEN 404/SOLIDWORKS/Pusher_75mm_Long1.STL
75.0 x 16.3 x 10.2
