ericrobles320140/Chilly-Dog-Team-31-ECEN_404/App and Modem/Enclosure/Encloser Top.SLDPRT

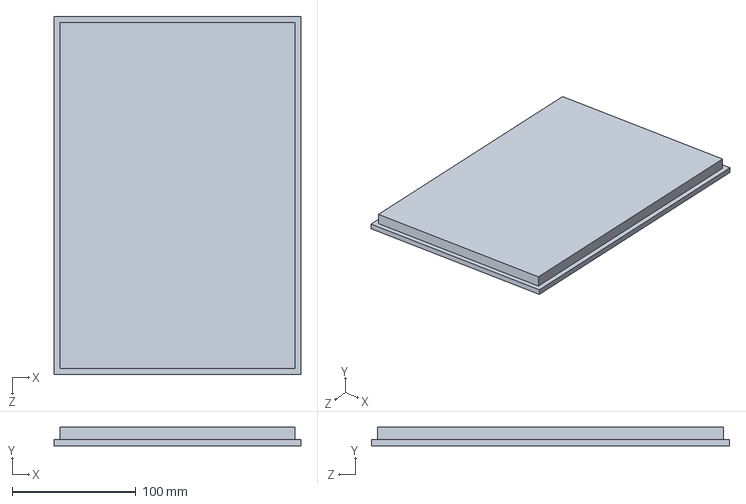
[picture p217: CAD file, 2022-12-01]
App and Modem/Enclosure/Encloser Top.SLDPRT
200.0 x 15.0 x 290.0 mm
