ericrobles320140/Chilly-Dog-Team-31-ECEN_404/App and Modem/Enclosure/Inverter.SLDPRT

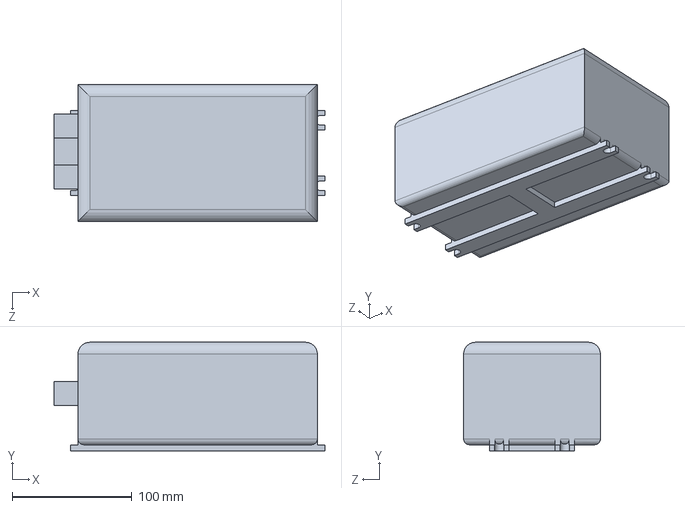
[picture p218: CAD file, 2022-12-01]
App and Modem/Enclosure/Inverter.SLDPRT
226.4 x 90.7 x 114.3 mm
