ericrobles320140/Chilly-Dog-Team-31-ECEN_404/(list of files, cad)

Other CAD files:
App and Modem/Enclosure/Encloser Bottom.STL
App and Modem/Enclosure/Encloser Top.STL
