ericrobles320140/Chilly-Dog-Team-31-ECEN_404/403/403/Con Ops/Resources/Concept of Operation_Outline.docx

# Concept of Operation – Outline

1. Executive Summary

2. Introduction

2.1. Background

2.2. Overview

2.3. Referenced Documents and Standards

3. Operating Concept

3.1. Scope

3.2. Operational Description and Constraints

3.3. System Description

3.4. Modes of Operations

3.5. Users

3.6. Support

4. Scenario(s)

4.1. Scenario Name #1

4.1. Scenario Name #2 … etc…

5. Analysis

5.1. Summary of Proposed Improvements

5.2. Disadvantages and Limitations

5.3. Alternatives

5.4. Impact
