ericrobles320140/Chilly-Dog-Team-31-ECEN_404/Power/Power Supply/Output Tests.docx

Power Supply Output Tests

Validation (12V)

MCU buck – 8.991V

Modem Buck - 4.986V

Line Regulation

- MCU
- Modem

Load Regulation

- MCU
- Modem
