ericrobles320140/Chilly-Dog-Team-31-ECEN_404/Power/Power Supply/404LineLoadTests.xlsx

MCU Buck Circuit |  |  |  |  | Final PCB
Perfboard | Load Testing | (@ nominal 12V) | Line Testing | (@ 800mA)
 | Current Draw (A) | Voltage @ Load (V) | Input Voltage (V) | Voltage @ Load (V) | MCU Buck | Load Testing | (@ nominal 12V) | Line Testing | (@ 800mA)
 | 0.05 | 8.93 | 11 | 8.521 |  | Current Draw (A) | Voltage @ Load (V) | Input Voltage (V) | Voltage @ Load (V)
 | 0.1 | 8.895 | 11.25 | 8.459 |  | 0 | 4.9177 | 11 | 4.4469
 | 0.153 | 8.876 | 11.5 | 8.426 |  | 0.05 | 4.8529 | 11.25 | 4.4458
 | 0.202 | 8.855 | 11.75 | 8.383 |  | 0.1 | 4.7949 | 11.5 | 4.4465
 | 0.25 | 8.831 | 12 | 8.347 |  | 0.153 | 4.7687 | 11.75 | 4.4457
 | 0.3 | 8.812 | 12.25 | 8.252 |  | 0.202 | 4.746 | 12 | 4.4444
 | 0.35 | 8.792 | 12.5 | 8.222 |  | 0.25 | 4.7223 | 12.25 | 4.4428
 | 0.4 | 8.767 | 12.75 | 8.211 |  | 0.3 | 4.6988 | 12.5 | 4.4419
 | 0.45 | 8.744 | 13 | 8.182 |  | 0.35 | 4.6747 | 12.75 | 4.4434
 | 0.5 | 8.718 |  |  |  | 0.4 | 4.652 | 13 | 4.4424
 | 0.55 | 8.645 |  |  |  | 0.45 | 4.6288 | 13.25 | 4.4421
 | 0.6 | 8.536 |  |  |  | 0.5 | 4.6049 | 13.5 | 4.4423
 | 0.65 | 8.48 |  |  |  | 0.55 | 4.5828 | 13.75 | 4.443
 | 0.7 | 8.398 |  |  |  | 0.6 | 4.5592 | 14 | 4.443
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
