ericrobles320140/Chilly-Dog-Team-31-ECEN_404/403/403/Midterm Report/FSR, ICD, Validation/Validation, Execution/Execution Timeline.xlsx

 | 2022-01-24 | 2022-01-31 | 2022-02-07 | 2022-02-14 | 2022-02-21 | 2022-02-28 | 2022-03-07 | 2022-03-14 | 2022-03-21 | 2022-03-28 | 2022-04-04 | 2022-04-11 | 2022-04-18 | 2022-04-25 | 2022-05-02 | Owner | Date Completed
Assigned Project and Team |  |  |  |  |  |  |  |  |  |  |  |  |  |  |  | All | 2022-01-24
Sponsor Introduction |  |  |  |  |  |  |  |  |  |  |  |  |  |  |  | All | 2022-01-25
Brain Storm Stage |  |  |  |  |  |  |  |  |  | Not started |  |  |  |  |  | All | 2022-01-31
Distribution of Subsections |  |  |  |  |  |  |  |  |  | In Progress |  |  |  |  |  | All | 2022-01-28
Concept of Operations |  |  |  |  |  |  |  |  |  | Completed |  |  |  |  |  | All | 2022-02-19
Research |  |  |  |  |  |  |  |  |  | Behind Schedule |  |  |  |  |  | All | 2022-02-21
Research and Choose AC Unit |  |  |  |  |  |  |  |  |  |  |  |  |  |  |  | All | 2022-02-21
Research Microcontroller Requirements |  |  |  |  |  |  |  |  |  |  |  |  |  |  |  | Yarentzy | 2022-02-21
Choose Microcontroller |  |  |  |  |  |  |  |  |  |  |  |  |  |  |  | Yarentzy | 2022-02-21
Download and begin testing with Android Studio |  |  |  |  |  |  |  |  |  |  |  |  |  |  |  | Martin | 2022-02-21
Submit Preliminary Parts Request |  |  |  |  |  |  |  |  |  |  |  |  |  |  |  | All | 2022-02-22
App layout and acquire cellular modem, sim, and antenna |  |  |  |  |  |  |  |  |  |  |  |  |  |  |  | Martin | 2022-02-22
Functional System Requirements |  |  |  |  |  |  |  |  |  |  |  |  |  |  |  | All | 2022-02-23
Interface Control Document |  |  |  |  |  |  |  |  |  |  |  |  |  |  |  | All | 2022-02-23
Midterm Presentation |  |  |  |  |  |  |  |  |  |  |  |  |  |  |  | All | 2022-02-23
Download MPLAB Software and Obtain Access to Debugger |  |  |  |  |  |  |  |  |  |  |  |  |  |  |  | Yarentzy | 2022-02-21
Familiarize myslef with MCC |  |  |  |  |  |  |  |  |  |  |  |  |  |  |  | Yarentzy | 2022-02-28
Configure System |  |  |  |  |  |  |  |  |  |  |  |  |  |  |  | Yarentzy | 2022-03-07
Configure I/O pins |  |  |  |  |  |  |  |  |  |  |  |  |  |  |  | Yarentzy | 2022-03-14
Create a Blinking LED |  |  |  |  |  |  |  |  |  |  |  |  |  |  |  | Yarentzy | 2022-03-21
Configure UART Serial Communication |  |  |  |  |  |  |  |  |  |  |  |  |  |  |  | Yarentzy | 2022-03-28
UART Serial Communication and PC Communication |  |  |  |  |  |  |  |  |  |  |  |  |  |  |  | Yarentzy | 2022-04-10
Design PCB and schematic for circuit |  |  |  |  |  |  |  |  |  |  |  |  |  |  |  | Grant | 2022-04-18
Order components and parts for power supply |  |  |  |  |  |  |  |  |  |  |  |  |  |  |  | Grant | 2022-04-08
Develop app to modem communication system |  |  |  |  |  |  |  |  |  |  |  |  |  |  |  | Martin | 2022-03-20
Configure MCU and ambient temperatrue sensor |  |  |  |  |  |  |  |  |  |  |  |  |  |  |  | Yarentzy | 2022-04-11
Make connection between app and modem |  |  |  |  |  |  |  |  |  |  |  |  |  |  |  | Martin | 2022-03-30
Test VAC side of power supply circuit |  |  |  |  |  |  |  |  |  |  |  |  |  |  |  | Grant | 2022-03-22
Solder and test MCU/control components |  |  |  |  |  |  |  |  |  |  |  |  |  |  |  | Grant
Validate the modem is able to send and receive the correct data |  |  |  |  |  |  |  |  |  |  |  |  |  |  |  | Martin | 2022-04-04
Implement Relay to control a large current load |  |  |  |  |  |  |  |  |  |  |  |  |  |  |  | Yarentzy | 2022-04-18
Establish AC Inputs |  |  |  |  |  |  |  |  |  |  |  |  |  |  |  | Yarentzy | 2022-04-11
Progress Update Presentations |  |  |  |  |  |  |  |  |  |  |  |  |  |  |  | All | 2022-03-14
Validate and test full power supply circuit |  |  |  |  |  |  |  |  |  |  |  |  |  |  |  | Grant | 2022-04-20
Implement GUI over the app |  |  |  |  |  |  |  |  |  |  |  |  |  |  |  | Martin | 2022-04-12
Validate the whole cellular subsystem is working together |  |  |  |  |  |  |  |  |  |  |  |  |  |  |  | Martin | 2022-04-11
Accept Input from PC |  |  |  |  |  |  |  |  |  |  |  |  |  |  |  | Yarentzy | 2022-04-11
Final Presentation |  |  |  |  |  |  |  |  |  |  |  |  |  |  |  | All | 2022-04-13
Subsystem Presentations |  |  |  |  |  |  |  |  |  |  |  |  |  |  |  | All | 2022-04-24
Final Report |  |  |  |  |  |  |  |  |  |  |  |  |  |  |  | All | 2022-04-30
