ericrobles320140/Chilly-Dog-Team-31-ECEN_404/MCU/ECEN 404/Testing/Temperature Output Testing.txt

Plug	Time (s)	Temperature 62	Plug Output 73 F	Plug Output 85 F		Battery	Battery Output 62 F	Battery Output 73 F	Battery Output 85 F
	2	68.54	68.9	71.78			72.68	73.4	73.94
	4	68.54	68.9	71.78			72.5	73.4	73.94
	6	68.54	68.9	71.6			72.68	73.4	73.76
	8	68.54	68.9	71.6			72.5	73.4	73.76
	10	68.54	68.9	71.6			72.68	73.4	73.94
	12	68.54	68.9	71.6			72.68	73.4	73.94
	14	68.54	68.9	71.6			72.68	73.4	73.76
	16	68.54	68.9	71.6			72.68	73.4	73.94
	18	68.54	68.9	71.6			72.68	73.4	73.94
	20	68.54	68.9	71.42			72.86	73.4	73.76
	22	68.54	68.9	71.42			72.86	73.4	73.76
	24	68.54	68.9	71.42			72.86	73.4	73.76
	26	68.54	68.72	71.42			72.86	73.4	73.76
	28	68.54	68.54	71.42			72.86	73.4	73.76
	30	68.54	68.36	71.42			72.86	73.4	73.76
	32	68.72	68.18	71.6			72.86	73.4	73.76
	34	68.72	68	71.42			72.86	73.4	73.76
	36	68.72	67.82	71.42			72.86	73.4	73.76
	38	68.36	67.64	71.42			72.86	73.4	73.76
	40	67.82	67.46	71.42			72.86	73.4	73.58
	42	67.1	67.28	71.6			72.86	73.4	73.76
	44	66.56	67.1	71.42			72.86	73.4	73.76
	46	66.2	66.92	71.42			72.86	73.4	73.76
	48	65.84	66.74	71.42			72.86	73.4	73.58
	50	65.66	66.56	71.42			72.86	73.4	73.58
	52	65.3	66.38	71.42			72.86	73.4	73.58
	54	64.76	66.38	71.6			72.86	73.4	73.58
	56	64.04	66.2	71.6			73.04	73.4	73.58
	58	62.96	66.2	71.6			72.86	73.4	73.58
	60	62.06	66.02	71.6			72.86	73.4	73.58
	62	61.16	66.02	71.6			72.86	73.4	73.58
	64	60.26	65.84	71.6			73.04	73.4	73.58
	66	59.54	65.84	71.6			72.86	73.4	73.58
	68	58.64	65.84	71.6			72.86	73.4	73.58
	70	58.28	65.84	71.6			73.04	73.4	73.58
	72	57.92	65.66	71.6			73.04	73.4	73.58
	74	57.38	65.66	71.6			72.86	73.4	73.58
	76	57.02	65.66	71.6			73.04	73.4	73.58
	78	56.84	65.66	71.6			73.04	73.4	73.58
	80	56.48	65.66	71.6			73.04	73.4	73.58
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
