ericrobles320140/Chilly-Dog-Team-31-ECEN_404/Power/Power Supply/Battery Testing/Battery Testing w Charging No VAC (Cloudy).xlsx

#Digilent WaveForms Oscilloscope Acquisition
#Device Name: Discovery2NI
#Serial Number: SN:210321AD0D48
#Date Time: 2022-11-24 12:05:53.252
#Sample rate: 1Hz
#Samples: 1024
#Trigger: Source: Channel 1 Type: Edge Condition: Rising Level: 12.79083 V Hyst.: Auto HoldOff: 0 s
#Channel 1: Range: 100 mV/div Offset: -12.7531 V Attenuation: 1 X Sample Mode: Average
Time (s) | Channel 1 (V) | Real Time (s) | Real Time (min)
-512 | 12.74345328 | 0 | 0
-511 | 12.74345328 | 1 | 0.01666666667
-510 | 12.74345328 | 2 | 0.03333333333
-509 | 12.74345328 | 3 | 0.05
-508 | 12.73974911 | 4 | 0.06666666667
-507 | 12.74345328 | 5 | 0.08333333333
-506 | 12.74345328 | 6 | 0.1
-505 | 12.73974911 | 7 | 0.1166666667
-504 | 12.73974911 | 8 | 0.1333333333
-503 | 12.73974911 | 9 | 0.15
-502 | 12.73974911 | 10 | 0.1666666667
-501 | 12.74715745 | 11 | 0.1833333333
-500 | 12.74715745 | 12 | 0.2
-499 | 12.71752406 | 13 | 0.2166666667
-498 | 12.74715745 | 14 | 0.2333333333
-497 | 12.75086163 | 15 | 0.25
-496 | 12.75086163 | 16 | 0.2666666667
-495 | 12.75086163 | 17 | 0.2833333333
-494 | 12.75086163 | 18 | 0.3
-493 | 12.75086163 | 19 | 0.3166666667
-492 | 12.75086163 | 20 | 0.3333333333
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
