ericrobles320140/Chilly-Dog-Team-31-ECEN_404/Power/Power Supply/Battery Testing/Battery Testing w Charging No VAC (Sunny).xlsx

#Digilent WaveForms Oscilloscope Acquisition
#Device Name: Discovery2NI
#Serial Number: SN:210321AD0D48
#Date Time: 2022-11-26 13:19:30.586
#Sample rate: 2.73067Hz
#Samples: 5804
#Trigger: Source: Channel 1 Type: Edge Condition: Rising Level: 12.68157 V Hyst.: Auto HoldOff: 100 ns
#Channel 1: Range: 500 mV/div Offset: -12.6805 V Attenuation: 1 X Sample Mode: Average
Time (s) | Channel 1 (V) | Real time (s) | Real Time (min)
0 | 12.68 | 0 | 0
-1464.84376 | 12.7379807 | 0.36624 | 0.006104 | Decent light
-1464.477549 | 14.14927121 | 0.73245094 | 0.01220751567 | Partly cloudy
-1464.111338 | 14.12704616 | 1.09866188 | 0.01831103133
-1463.745127 | 14.14186286 | 1.46487282 | 0.024414547
-1463.378916 | 14.12704616 | 1.83108376 | 0.03051806267
-1463.012705 | 14.13815868 | 2.1972947 | 0.03662157833
-1462.646494 | 14.13075033 | 2.56350564 | 0.042725094
-1462.280283 | 14.12704616 | 2.92971658 | 0.04882860967
-1461.914072 | 14.12704616 | 3.29592752 | 0.05493212533
-1461.547862 | 14.12704616 | 3.66213846 | 0.061035641
-1461.181651 | 14.13445451 | 4.0283494 | 0.06713915667
-1460.81544 | 14.12334198 | 4.39456034 | 0.07324267233
-1460.449229 | 14.11593363 | 4.76077128 | 0.079346188
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
