ericrobles320140/Chilly-Dog-Team-31-ECEN_404/Power/Power Supply/Battery Testing/BattTest11-28-ChargingwVAC.xlsx

#Digilent WaveForms Oscilloscope Acquisition
#Device Name: Discovery2NI
#Serial Number: SN:210321AD0D48
#Date Time: 2022-11-28 16:53:12.959
#Sample rate: 0.455111Hz
#Samples: 1497
#Trigger: Source: Channel 1 Type: Edge Condition: Rising Level: 12.89192 V Hyst.: Auto HoldOff: 100 ns
#Channel 1: Range: 500 mV/div Offset: -12.8865 V Attenuation: 1 X Sample Mode: Average
Time (s) | Channel 1 (V) | Real time (s) | Real time (min)
-8789.06252 | 12.89164647 | 0 | 0
-8786.865254 | 12.89905482 | 2.19726563 | 0.03662109383
-8784.667989 | 12.89905482 | 4.39453126 | 0.07324218767
-8782.470723 | 12.89905482 | 6.59179689 | 0.1098632815
-8780.273457 | 12.89905482 | 8.78906252 | 0.1464843753
-8778.076192 | 12.89905482 | 10.98632815 | 0.1831054692
-8775.878926 | 12.89905482 | 13.18359378 | 0.219726563
-8773.681661 | 12.89905482 | 15.38085941 | 0.2563476568
-8771.484395 | 12.89905482 | 17.57812504 | 0.2929687507
-8769.287129 | 12.89905482 | 19.77539067 | 0.3295898445
-8767.089864 | 12.89905482 | 21.9726563 | 0.3662109383
-8764.892598 | 12.89535065 | 24.16992193 | 0.4028320322
-8762.695332 | 12.89535065 | 26.36718756 | 0.439453126
-8760.498067 | 12.89535065 | 28.56445319 | 0.4760742198
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
