ericrobles320140/Chilly-Dog-Team-31-ECEN_404/Power/Power Supply/Battery Testing/BattTestFullLoadnoCharging.xlsx

#Digilent WaveForms Oscilloscope Acquisition
#Device Name: Discovery2NI
#Serial Number: SN:210321AD0D48
#Date Time: 2022-11-29 09:43:33.417
#Sample rate: 2.73067Hz
#Samples: 7656
#Trigger: Source: Channel 1 Type: Edge Condition: Rising Level: 12.92383 V Hyst.: Auto HoldOff: 100 ns
#Channel 1: Range: 500 mV/div Offset: -12.924 V Attenuation: 1 X Sample Mode: Average
Time (s) | Channel 1 (V) | Real time (sec) | Real Time (min)
35.15624 | 12.89808694 | 0 | 0
35.52245094 | 12.89067859 | 0.36621094 | 0.006103515667
35.88866188 | 12.89067859 | 0.73242188 | 0.01220703133
36.25487282 | 12.89067859 | 1.09863282 | 0.018310547
36.62108376 | 12.89067859 | 1.46484376 | 0.02441406267
36.9872947 | 12.89067859 | 1.8310547 | 0.03051757833
37.35350564 | 12.89067859 | 2.19726564 | 0.036621094
37.71971658 | 12.89067859 | 2.56347658 | 0.04272460967
38.08592752 | 12.89067859 | 2.92968752 | 0.04882812533
38.45213846 | 12.89067859 | 3.29589846 | 0.054931641
38.8183494 | 12.89067859 | 3.6621094 | 0.06103515667
39.18456034 | 12.89067859 | 4.02832034 | 0.06713867233
39.55077128 | 12.89067859 | 4.39453128 | 0.073242188
39.91698222 | 12.89067859 | 4.76074222 | 0.07934570367
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
