ericrobles320140/Chilly-Dog-Team-31-ECEN_404/MCU/ECEN 404/Arduino Code/DHT_Sensor/Sensor 2 Screenshots/Sensor 2 Failure.PNG

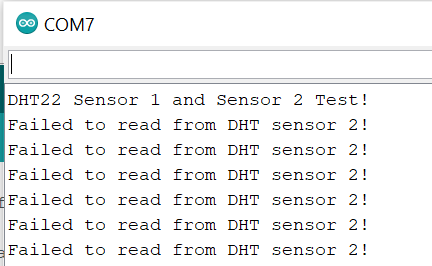
MCU/ECEN 404/Arduino Code/DHT_Sensor/Sensor 2 Screenshots/Sensor 2 Failure.PNG
