ericrobles320140/Chilly-Dog-Team-31-ECEN_404/(list of files, drawings)

Other design files:
Power/Power Supply/PCB Design/Capstone Power Supply/Capstone Power Supply.PrjPcb
Power/Power Supply/PCB Design/Capstone Power Supply/Power Schematic.SchDoc
Power/Power Supply/Power Supply Simulation/404_Power_Supply_Multisim.ms14
