ericrobles320140/Chilly-Dog-Team-31-ECEN_404/MCU/ECEN 404/Arduino Code/Remote0915/SendAndReceive_doesnt_recieve_accurately/SendAndReceive_doesnt_recieve_accurately.ino

/*
 * SendAndReceive.cpp
 *
 * Demonstrates sending IR codes and receiving it simultaneously
 *
 *  This file is part of Arduino-IRremote https://github.com/Arduino-IRremote/Arduino-IRremote.
 *
 ************************************************************************************
 * MIT License
 *
 * Copyright (c) 2021 Armin Joachimsmeyer
 *
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
 ************************************************************************************
 */

#include <Arduino.h>

// select only NEC and the universal decoder for pulse distance protocols
//#define DECODE_NEC          // Includes Apple and Onkyo
//#define DECODE_DISTANCE     // in case NEC is not received correctly
#define DECODE_SAMSUNG

//#define EXCLUDE_UNIVERSAL_PROTOCOLS // Saves up to 1000 bytes program memory.
//#define EXCLUDE_EXOTIC_PROTOCOLS
//#define SEND_PWM_BY_TIMER
//#define USE_NO_SEND_PWM
//#define NO_LED_FEEDBACK_CODE // saves 500 bytes program memory
//#define DEBUG // Activate this for lots of lovely debug output from the decoders.

#include "PinDefinitionsAndMore.h" // Define macros for input and output pin etc.
#include <IRremote.hpp>

#define DELAY_AFTER_SEND 2000
#define DELAY_AFTER_LOOP 5000

void setup() {
    Serial.begin(115200);
#if defined(__AVR_ATmega32U4__) || defined(SERIAL_PORT_USBVIRTUAL) || defined(SERIAL_USB) /*stm32duino*/|| defined(USBCON) /*STM32_stm32*/|| defined(SERIALUSB_PID) || defined(ARDUINO_attiny3217)
    delay(4000); // To be able to connect Serial monitor after reset or power up and before first print out. Do not wait for an attached Serial Monitor!
#endif
    // Just to know which program is running on my Arduino
    Serial.println(F("START " __FILE__ " from " __DATE__ "\r\nUsing library version " VERSION_IRREMOTE));

    // Start the receiver and if not 3. parameter specified, take LED_BUILTIN pin from the internal boards definition as default feedback LED
    IrReceiver.begin(IR_RECEIVE_PIN, ENABLE_LED_FEEDBACK);

#if defined(IR_SEND_PIN)
    IrSender.begin(); // Start with IR_SEND_PIN as send pin and enable feedback LED at default feedback LED pin
#else
    IrSender.begin(3, ENABLE_LED_FEEDBACK); // Specify send pin and enable feedback LED at default feedback LED pin
#endif

    Serial.print(F("Ready to receive IR signals of protocols: "));
    printActiveIRProtocols(&Serial);
    Serial.println(F("at pin " STR(IR_RECEIVE_PIN)));

    Serial.println(F("Ready to send IR signals at pin " STR(IR_SEND_PIN)));


#if FLASHEND >= 0x3FFF  // For 16k flash or more, like ATtiny1604
// For esp32 we use PWM generation by ledcWrite() for each pin.
#  if !defined(SEND_PWM_BY_TIMER) && !defined(USE_NO_SEND_PWM) && !defined(ESP32)
    /*
     * Print internal software PWM generation info
     */
    IrSender.enableIROut(38); // Call it with 38 kHz to initialize the values printed below
    Serial.print(F("Send signal mark duration is "));
    Serial.print(IrSender.periodOnTimeMicros);
    Serial.print(F(" us, pulse correction is "));
    Serial.print(IrSender.getPulseCorrectionNanos());
    Serial.print(F(" ns, total period is "));
    Serial.print(IrSender.periodTimeMicros);
    Serial.println(F(" us"));
#  endif

    // infos for receive
    Serial.print(RECORD_GAP_MICROS);
    Serial.println(F(" us is the (minimum) gap, after which the start of a new IR packet is assumed"));
    Serial.print(MARK_EXCESS_MICROS);
    Serial.println(F(" us are subtracted from all marks and added to all spaces for decoding"));
#endif
}

uint16_t sAddress = 0x4085;
uint8_t sCommand = 0xFF40;
uint8_t sRepeats = 0;

/*
 * Send NEC IR protocol
 */
void send_ir_data() {
    Serial.print(F("Sending: 0x"));
    Serial.print(sAddress, HEX);
    Serial.print(sCommand, HEX);
    Serial.println(sRepeats, HEX);

    // clip repeats at 4
    //if (sRepeats > 4) {
    //    sRepeats = 4;
    //}
    // Results for the first loop to: Protocol=NEC Address=0x102 Command=0x34 Raw-Data=0xCB340102 (32 bits)
    IrSender.sendSamsung(sAddress, sCommand, sRepeats);
}

void receive_ir_data() {
    if (IrReceiver.decode()) {
        Serial.print(F("Decoded protocol: "));
        Serial.print(getProtocolString(IrReceiver.decodedIRData.protocol));
        Serial.print(F("Decoded raw data: "));
        Serial.print(IrReceiver.decodedIRData.decodedRawData, HEX);
        Serial.print(F(", decoded address: "));
        Serial.print(IrReceiver.decodedIRData.address, HEX);
        Serial.print(F(", decoded command: "));
        Serial.println(IrReceiver.decodedIRData.command, HEX);
        IrReceiver.resume();
    }
}

void loop() {
    /*
     * Print loop values
     */
    Serial.println();
    Serial.print(F("address=0x"));
    Serial.print(sAddress, HEX);
    Serial.print(F(" command=0x"));
    Serial.print(sCommand, HEX);
    Serial.print(F(" repeats="));
    Serial.println(sRepeats);
    Serial.flush();

    send_ir_data();
    // wait for the receiver state machine to detect the end of a protocol
    delay((RECORD_GAP_MICROS / 1000) + 5);
    receive_ir_data();

    // Prepare data for next loop
    //sAddress += 0x0101;
    //sCommand += 0x11;
    //sRepeats++;

    delay(100); // Loop delay
}
