ericrobles320140/Chilly-Dog-Team-31-ECEN_404/MCU/ECEN 404/Arduino Code/Servo Motor/sweep_with_input/sweep_with_input.ino

/* Sweep
 by BARRAGAN <http://barraganstudio.com>
 This example code is in the public domain.

 modified 8 Nov 2013
 by Scott Fitzgerald
 https://www.arduino.cc/en/Tutorial/LibraryExamples/Sweep
*/

#include <Servo.h>

Servo myservo;  // create servo object to control a servo
// twelve servo objects can be created on most boards

int pos = 0;    // variable to store the servo position
int on = 0;

void setup() {
  myservo.attach(2);  // attaches the servo on pin 9 to the servo object

  Serial.begin(9600);
}

void loop() {

  Serial.print("Turn device on? 1 for on 2 for off"); 

  while(Serial.available() == 0) { 
  }

  int userinput = Serial.parseInt();

  switch (userinput) {
    case 1:
      for (pos = 0; pos <= 90; pos += 1) { // goes from 0 degrees to 180 degrees
        // in steps of 1 degree
        myservo.write(pos);              // tell servo to go to position in variable 'pos'
        delay(15);                       // waits 15 ms for the servo to reach the position
      }
        for (pos = 90; pos >= 0; pos -= 1) { // goes from 180 degrees to 0 degrees
        myservo.write(pos);              // tell servo to go to position in variable 'pos'
        delay(15);                       // waits 15 ms for the servo to reach the position
      }
      
    
  }
    
  
  
  
}
