ericrobles320140/Chilly-Dog-Team-31-ECEN_404/MCU/ECEN 404/Arduino Code/Remote/Decoding_Remote_Attempt_1/Decoding_Remote_Attempt_1.ino

#include <IRremote.h>

int RECV_PIN = 11;

IRrecv irrecv(RECV_PIN);

decode_results results;

void setup()
{
  Serial.begin(9600);
  irrecv.enableIRIn(); // Start the receiver
}

void loop() {
  if (irrecv.decode(&results)) {
   
    Serial.println(results.value, HEX);
    irrecv.resume(); // Receive the next value
  }
}

//
