ericrobles320140/Chilly-Dog-Team-31-ECEN_404/MCU/ECEN 404/Arduino Code/Remote/Determining_Protocol/Determining_Protocol.ino

#include <IRremote.h>

const int RECV_PIN = 30;
IRrecv irrecv(RECV_PIN);
decode_results results;

void setup(){
  Serial.begin(9600);
  irrecv.enableIRIn();
  irrecv.blink13(true);
}

void loop(){
  if (irrecv.decode(&results)){
        Serial.println(results.value, HEX);
        switch (results.decode_type){
            case NEC: Serial.println("NEC"); break ;
            case SONY: Serial.println("SONY"); break ;
            case RC5: Serial.println("RC5"); break ;
            case RC6: Serial.println("RC6"); break ;
            //case DISH: Serial.println("DISH"); break ;
            case SHARP: Serial.println("SHARP"); break ;
            case JVC: Serial.println("JVC"); break ;
            //case SANYO: Serial.println("SANYO"); break ;
            //case MITSUBISHI: Serial.println("MITSUBISHI"); break ;
            //case SAMSUNG: Serial.println("SAMSUNG"); break ;
            case LG: Serial.println("LG"); break ;
            case WHYNTER: Serial.println("WHYNTER"); break ;
            //case AIWA_RC_T501: Serial.println("AIWA_RC_T501"); break ;
            case PANASONIC: Serial.println("PANASONIC"); break ;
            case DENON: Serial.println("DENON"); break ;
          default:
            case UNKNOWN: Serial.println("UNKNOWN"); break ;
          }
        irrecv.resume();
 }
}
