ericrobles320140/Chilly-Dog-Team-31-ECEN_404/MCU/ECEN 404/Arduino Code/Remote0916/Sending_on-off FAIL/Sending_on-off_FAIL/Sending_on-off_FAIL.ino

#include <Arduino.h>
#include "PinDefinitionsAndMore.h" // Define macros for input and output pin etc.
#include <IRremote.hpp>

void setup() {
  pinMode(LED_BUILTIN, OUTPUT);

  Serial.begin(115200);

}

void loop() {
   //IrSender.sendSamsung(0x4185, 0xFF41, 0); //turn on
   IrSender.sendSamsung(0x4085, 0xFF40, 3); //turn off
   

   delay(1000);

}
