ericrobles320140/Chilly-Dog-Team-31-ECEN_404/(commit log)

2022-12-01 Battery Charging
2022-12-01 403 Documentation
    [Execution Timeline.xlsx, Internal Vehicle Temperature vs Ambient Temperature.xlsx, Validation Plan.xlsx]
